Hasatio/esp32DevKitS/Rev0/Rev0.kicad_pcb

## KiCad design Rev0/Rev0.kicad_pcb (2024-02-27, an earlier design)

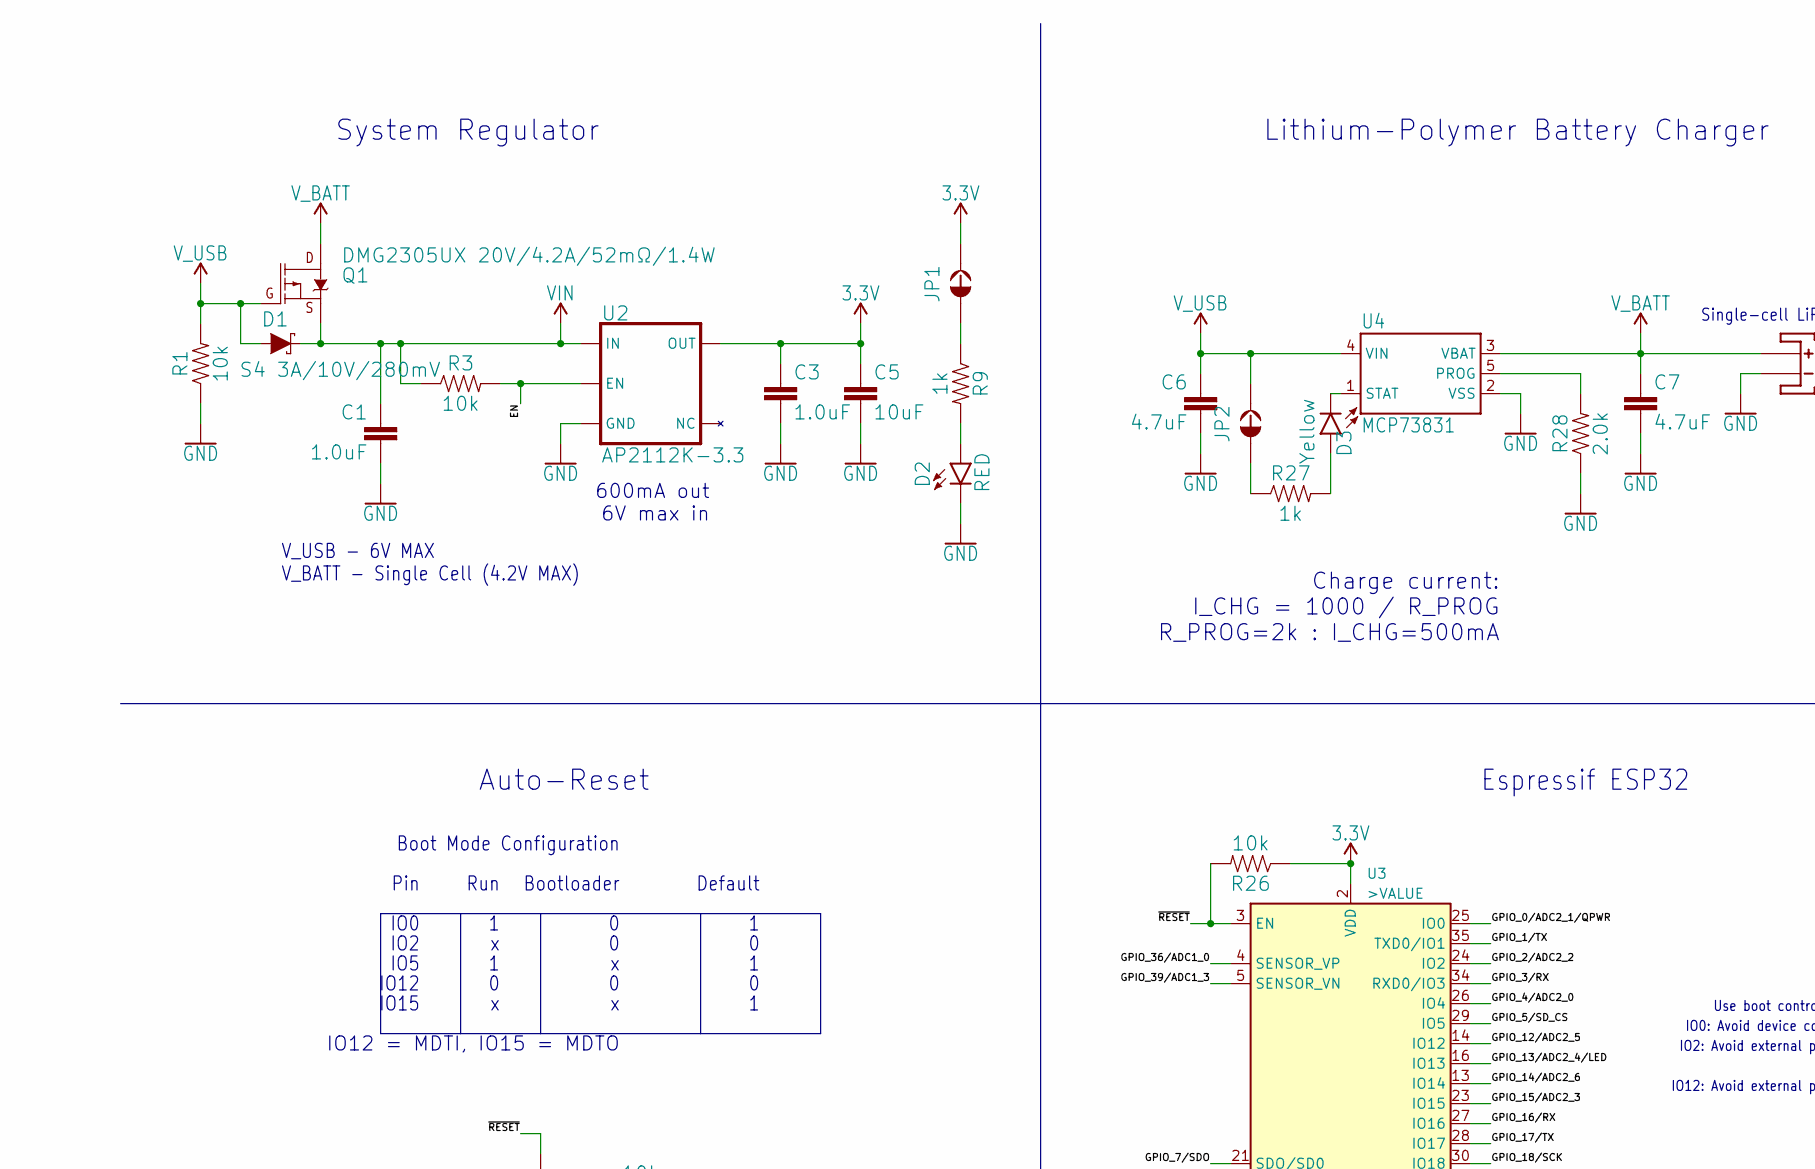
[picture p1: schematic Rev0.kicad_sch, ESP32-DEVKIT-S, part in row 1, column 1]

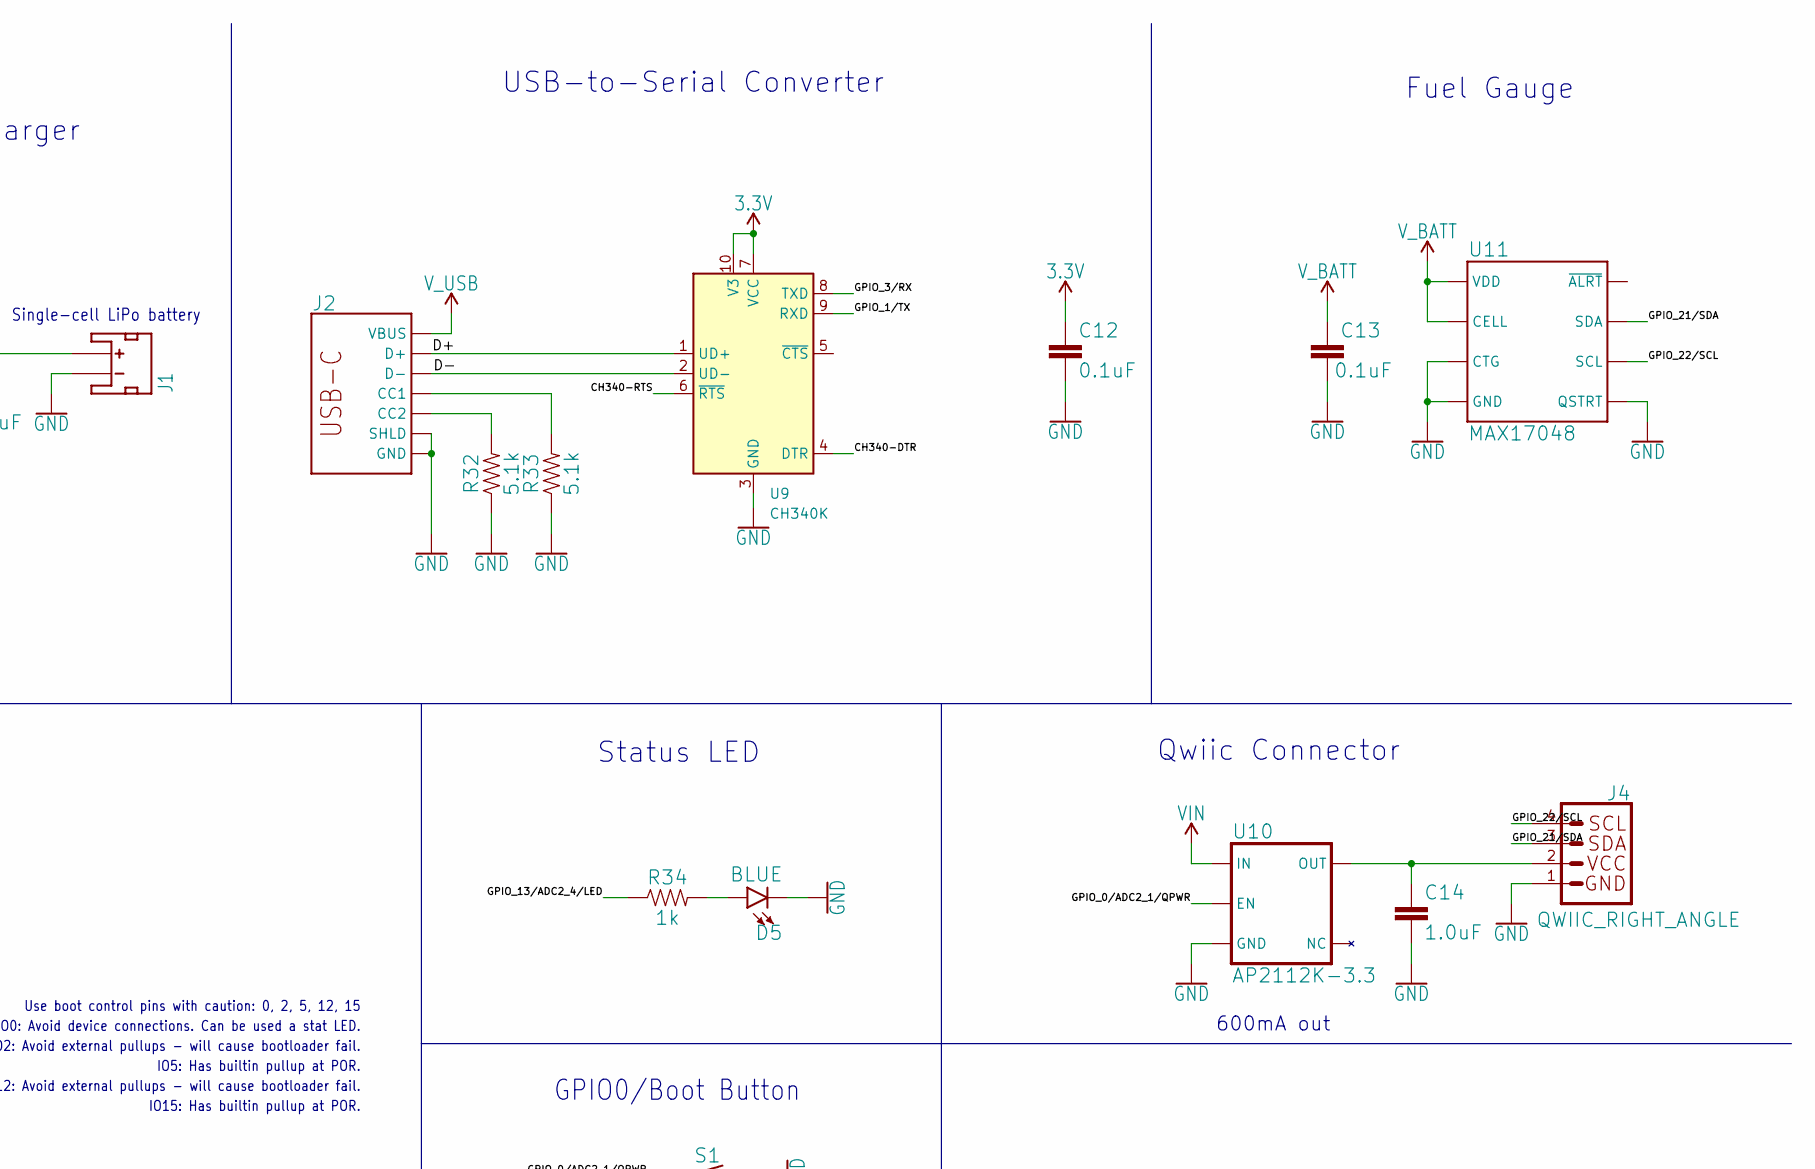
[picture p2: schematic Rev0.kicad_sch, ESP32-DEVKIT-S, part in row 1, column 2]

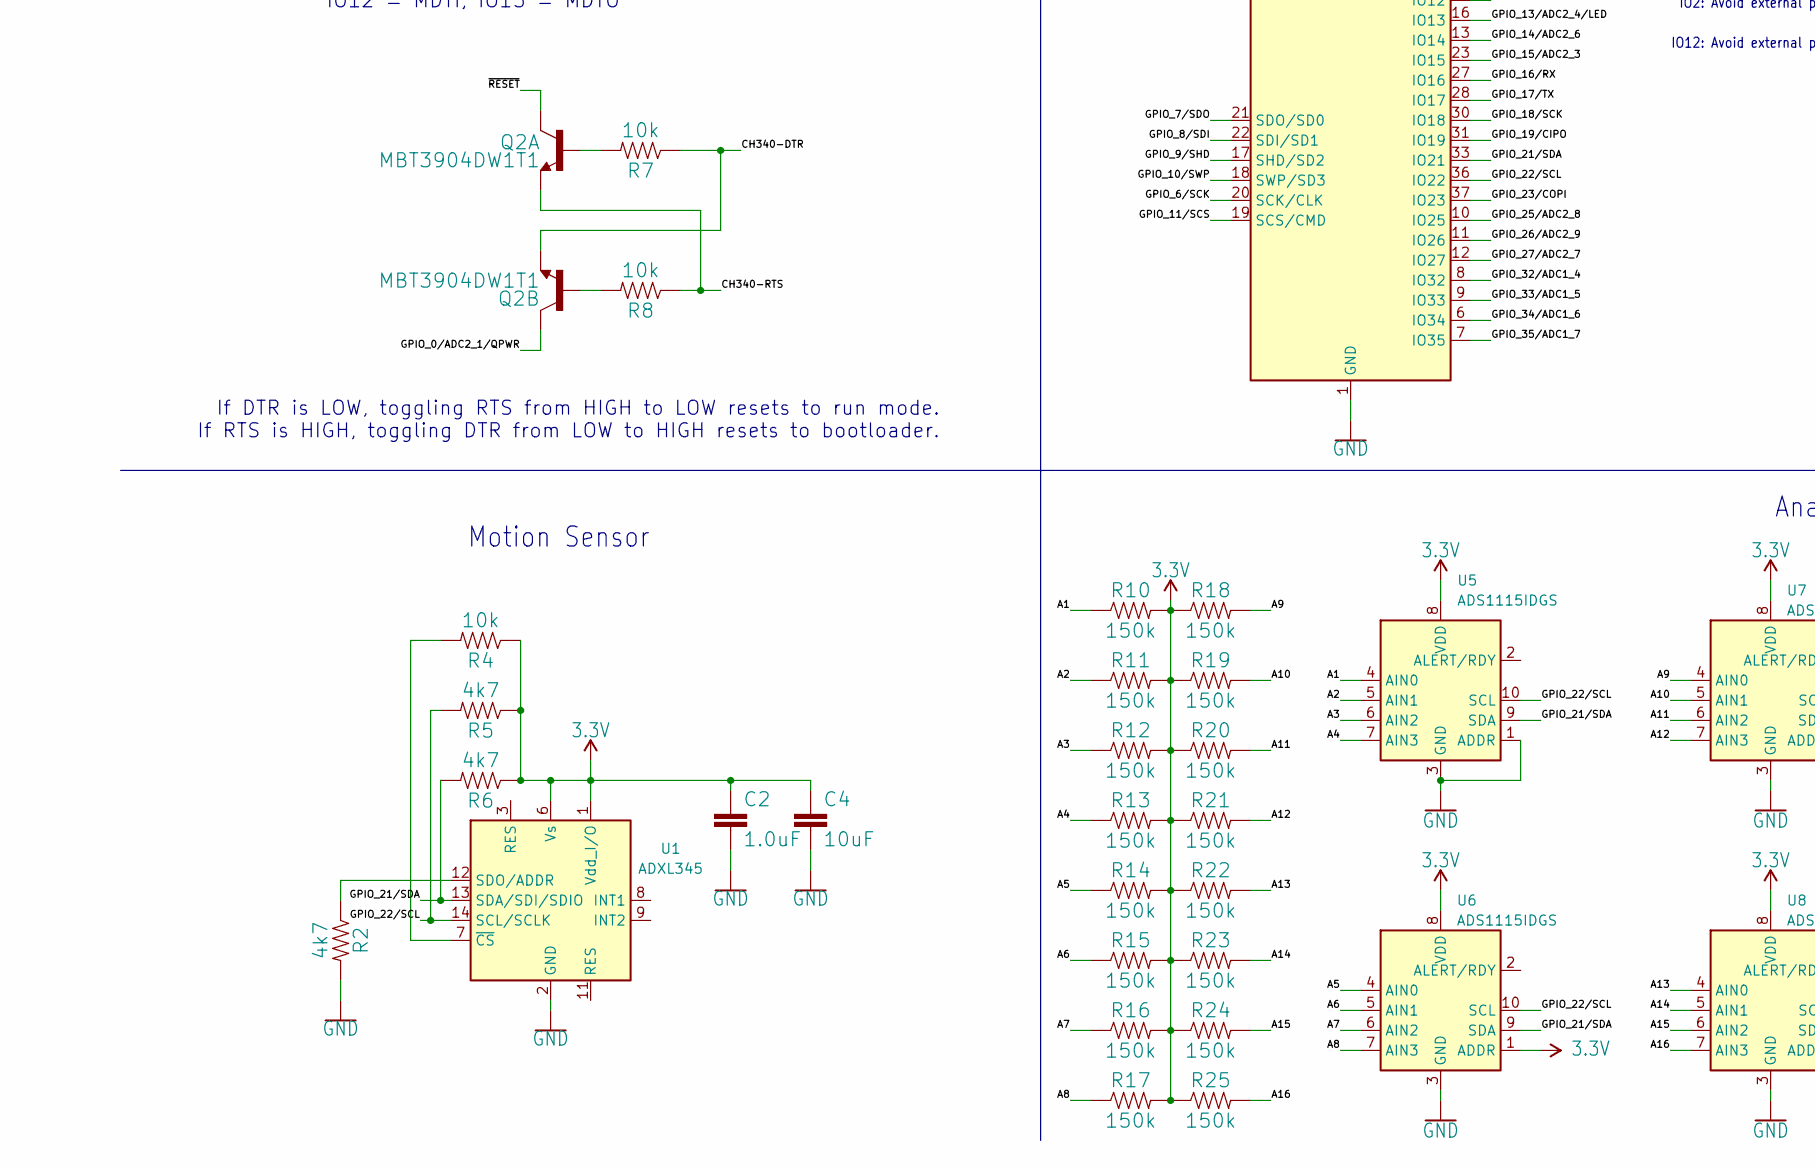
[picture p3: schematic Rev0.kicad_sch, ESP32-DEVKIT-S, part in row 2, column 1]

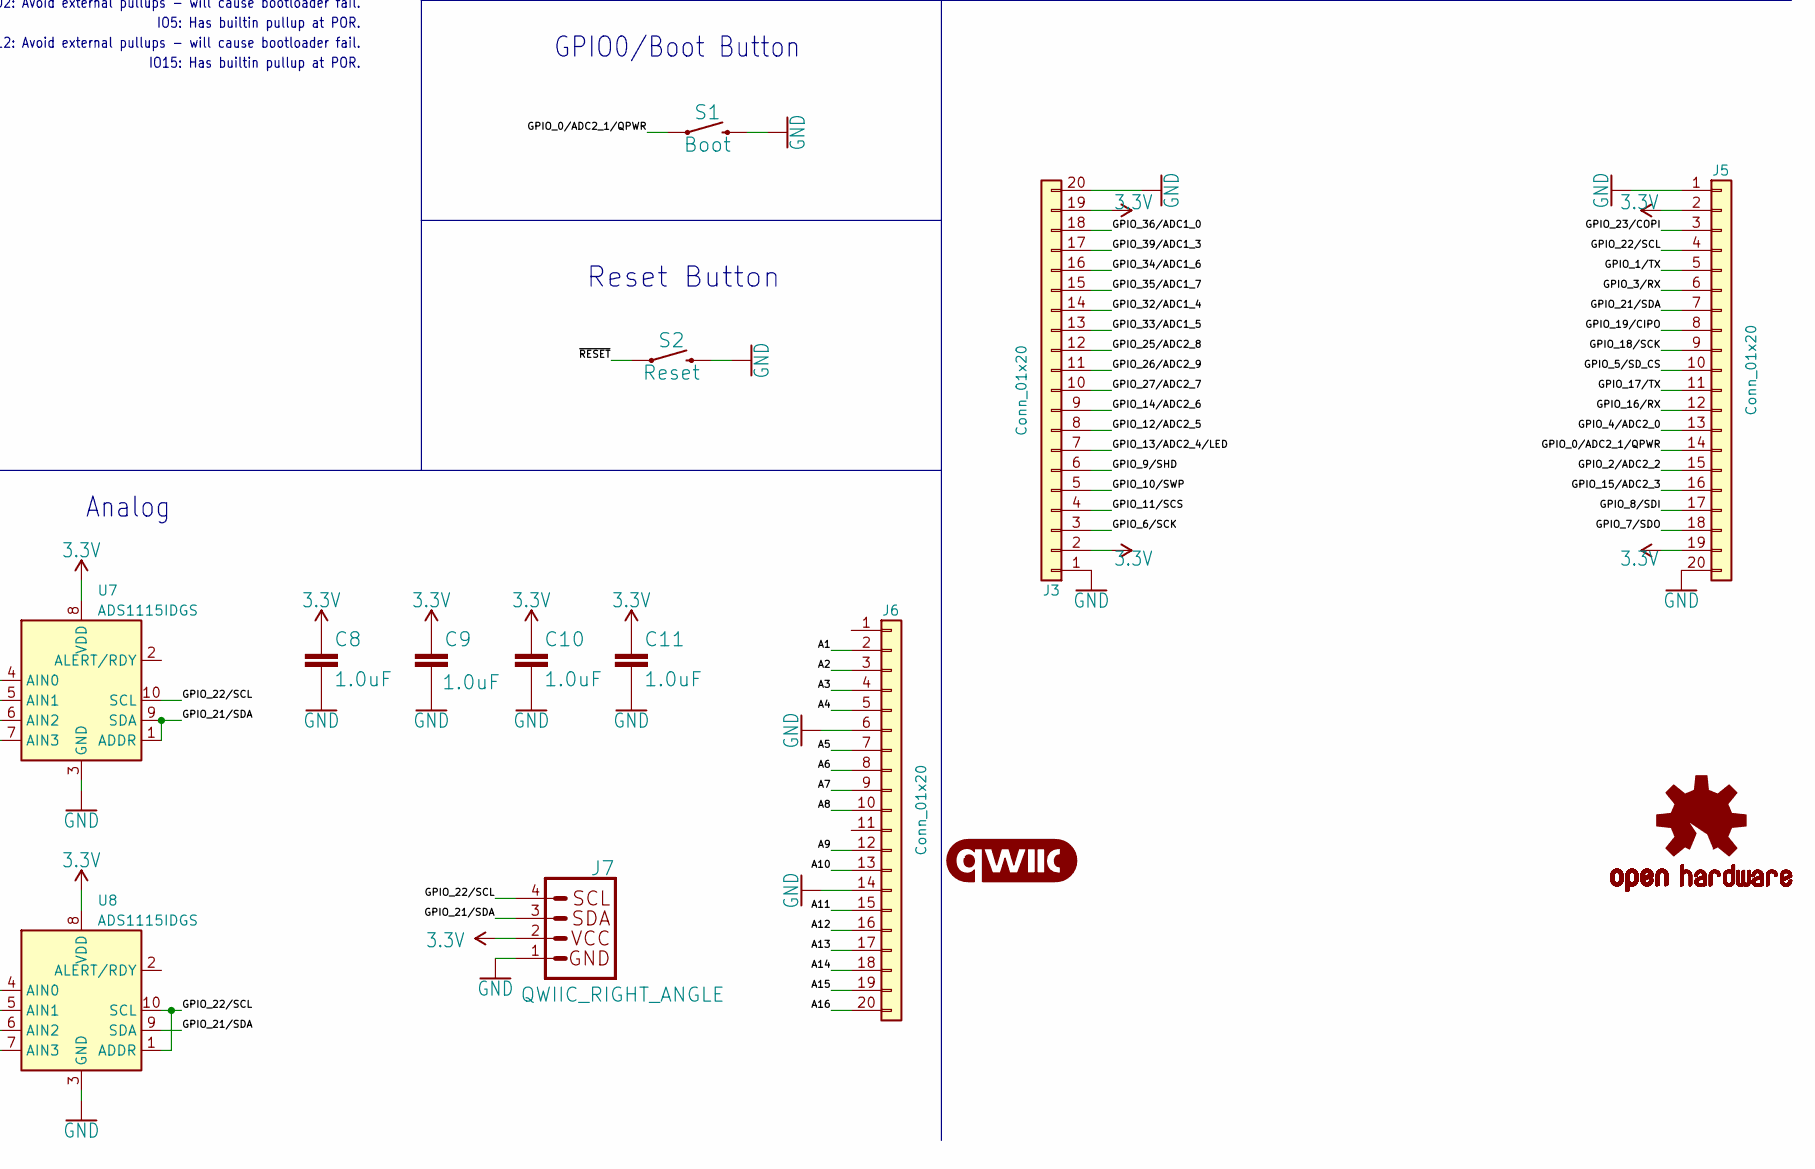
[picture p4: schematic Rev0.kicad_sch, ESP32-DEVKIT-S, part in row 2, column 2]

Parts:
C1, C2, C3, C8, C9, C10, C11, C14: 1.0uF; 0402-TIGHT
C4, C5: 10uF; 0402-TIGHT
C6, C7: 4.7uF; 0402-TIGHT
C12, C13: 0.1uF; 0402-TIGHT
D1: S4 3A/10V/280mV; SOD-323
D2: RED; LED-0603
D3: Yellow; LED-0603
D5: BLUE; LED-0603
J1: JST_2MM_MALE; JST-2-SMD
J2: USB_C_2-LAYER_PADS; USB-C-16P-2LAYER-PADS
J3, J5, J6: Conn_01x20; Molex_200528-0200_1x20-1MP_P1.00mm_Horizontal
J4, J7: QWIIC_RIGHT_ANGLE; JST04_1MM_RA
JP1, JP2: JUMPER-SMT_2_NC_TRACE_SILK; SMT-JUMPER_2_NC_TRACE_SILK
LOGO1: QWIIC_LOGO_4MM; QWIIC_4MM
LOGO2: OSHW-LOGOMINI; OSHW-LOGO-MINI
Q1: DMG2305UX 20V/4.2A/52mΩ/1.4W; SOT23-3
Q2: MBT3904DW1T1; SC70-6
R1, R3, R4, R7, R8, R26: 10k; 0402-TIGHT
R2, R5, R6: 4k7; 0402-TIGHT
R9, R27, R34: 1k; 0402-TIGHT
R10, R11, R12, R13, R14, R15, R16, R17, R18, R19, R20, R21, R22, R23, R24, R25: 150k; 0402-TIGHT
R28: 2.0k; 0402-TIGHT
R32, R33: 5.1k; 0402-TIGHT
S1: Boot; TACTILE_SWITCH_SMD_4.6X2.8MM
S2: Reset; TACTILE_SWITCH_SMD_4.6X2.8MM
U1: ADXL345; LGA-14_3x5mm_P0.8mm_LayoutBorder1x6y
U2, U10: SOT23-5
U3: >VALUE; ESP-WROOM-32-NARROW
U4: MCP73831; SOT23-5
U5, U6, U7, U8: ADS1115IDGS; TSSOP-10_3x3mm_P0.5mm
U9: CH340K; SSOP-10_3.9x4.9mm_P1.00mm
U11: MAX17048; DFN-8

Connections:
3.3V: C2.1, C3.1, C4.1, C5.1, C8.1, C9.1, C10.1, C11.1, C12.1, J3.2, J3.19, J5.2, J5.19, J7.2, JP1.2, R4.1, R5.1, R6.1, R10.2, R11.2, R12.2, R13.2, R14.2, R15.2, R16.2, R17.2, R18.1, R19.1, R20.1, R21.1, R22.1, R23.1, R24.1, R25.1, R26.1, U1.1 (Vdd_I/O), U1.6 (Vs), U2.5 (OUT), U3.2 (VDD), U5.8 (VDD), U6.1 (ADDR), U6.8 (VDD), U7.8 (VDD), U8.8 (VDD), U9.7 (VCC), U9.10 (V3); also elsewhere on the board
/A1: J6.2, R10.1, U5.4 (AIN0); also elsewhere on the board
/A2: J6.3, R11.1, U5.5 (AIN1); also elsewhere on the board
/A3: J6.4, R12.1, U5.6 (AIN2); also elsewhere on the board
/A4: J6.5, R13.1, U5.7 (AIN3); also elsewhere on the board
/A5: J6.7, R14.1, U6.4 (AIN0); also elsewhere on the board
/A6: J6.8, R15.1, U6.5 (AIN1); also elsewhere on the board
/A7: J6.9, R16.1, U6.6 (AIN2); also elsewhere on the board
/A8: J6.10, R17.1, U6.7 (AIN3); also elsewhere on the board
/A9: J6.12, R18.2, U7.4 (AIN0); also elsewhere on the board
/A10: J6.13, R19.2, U7.5 (AIN1); also elsewhere on the board
/A11: J6.15, R20.2, U7.6 (AIN2); also elsewhere on the board
/A12: J6.16, R21.2, U7.7 (AIN3); also elsewhere on the board
/A13: J6.17, R22.2, U8.4 (AIN0); also elsewhere on the board
/A14: J6.18, R23.2, U8.5 (AIN1); also elsewhere on the board
/A15: J6.19, R24.2, U8.6 (AIN2); also elsewhere on the board
/A16: J6.20, R25.2, U8.7 (AIN3); also elsewhere on the board
/CH340-DTR: Q2.1 (E), R7.1, U9.4 (DTR)
/CH340-RTS: Q2.4 (E), R8.1, U9.6 (~RTS)
/D+: J2.A6 (D+), J2.B6 (D+), U9.1 (UD+)
/D-: J2.A7 (D-), J2.B7 (D-), U9.2 (UD-)
/EN: R3.2, U2.3 (EN)
/GPIO_0/ADC2_1/QPWR: J5.14, Q2.6 (C), S1.1, S1.2 (1), U3.25 (IO0), U10.3 (EN); also elsewhere on the board
/GPIO_2/ADC2_2: J5.15, U3.24 (IO2)
/GPIO_4/ADC2_0: J5.13, U3.26 (IO4)
/GPIO_5/SD_CS: J5.10, U3.29 (IO5)
/GPIO_6/SCK: J3.3, U3.20 (SCK/CLK)
/GPIO_7/SDO: J5.18, U3.21 (SDO/SD0)
/GPIO_8/SDI: J5.17, U3.22 (SDI/SD1)
/GPIO_9/SHD: J3.6, U3.17 (SHD/SD2)
/GPIO_10/SWP: J3.5, U3.18 (SWP/SD3)
/GPIO_11/SCS: J3.4, U3.19 (SCS/CMD)
/GPIO_12/ADC2_5: J3.8, U3.14 (IO12)
/GPIO_13/ADC2_4/LED: J3.7, R34.1, U3.16 (IO13)
/GPIO_14/ADC2_6: J3.9, U3.13 (IO14)
/GPIO_15/ADC2_3: J5.16, U3.23 (IO15)
/GPIO_16/RX: J5.12, U3.27 (IO16)
/GPIO_17/TX: J5.11, U3.28 (IO17)
/GPIO_18/SCK: J5.9, U3.30 (IO18)
/GPIO_19/CIPO: J5.8, U3.31 (IO19)
/GPIO_21/SDA: J4.3, J5.7, J7.3, R6.2, U1.13 (SDA/SDI/SDIO), U3.33 (IO21), U5.9 (SDA), U6.9 (SDA), U7.1 (ADDR), U7.9 (SDA), U8.9 (SDA), U11.8 (SDA); also elsewhere on the board
/GPIO_22/SCL: J4.4, J5.4, J7.4, R5.2, U1.14 (SCL/SCLK), U3.36 (IO22), U5.10 (SCL), U6.10 (SCL), U7.10 (SCL), U8.1 (ADDR), U8.10 (SCL), U11.7 (SCL); also elsewhere on the board
/GPIO_23/COPI: J5.3, U3.37 (IO23)
/GPIO_25/ADC2_8: J3.12, U3.10 (IO25)
/GPIO_26/ADC2_9: J3.11, U3.11 (IO26)
/GPIO_27/ADC2_7: J3.10, U3.12 (IO27)
/GPIO_32/ADC1_4: J3.14, U3.8 (IO32)
/GPIO_33/ADC1_5: J3.13, U3.9 (IO33)
/GPIO_34/ADC1_6: J3.16, U3.6 (IO34)
/GPIO_35/ADC1_7: J3.15, U3.7 (IO35)
/GPIO_36/ADC1_0: J3.18, U3.4 (SENSOR_VP)
/GPIO_39/ADC1_3: J3.17, U3.5 (SENSOR_VN)
/~RESET: Q2.3 (C), R26.2, S2.1, S2.2 (1), U3.3 (EN); also elsewhere on the board
GND: C1.2, C2.2, C3.2, C4.2, C5.2, C6.2, C7.2, C8.2, C9.2, C10.2, C11.2, C12.2, C13.2, C14.2, D2.C, D5.C, J1.1 (-), J2.GND, J2.GND2 (GND), J2.SHLD1 (SHLD), J2.SHLD2 (SHLD), J2.SHLD3 (SHLD), J2.SHLD4 (SHLD), J3.1, J3.20, J4.1, J5.1, J5.20, J6.6, J6.14, J7.1, R1.1, R2.2, R28.1, R32.1, R33.1, S1.3 (2), S1.4 (2), S2.3 (2), S2.4 (2), U1.2 (GND), U1.4 (GND), U1.5 (GND), U2.2 (GND), U3.1 (GND), U3.15 (GND), U3.38 (GND), U3.39 (GND), U4.2 (VSS), U5.1 (ADDR), U5.3 (GND), U6.3 (GND), U7.3 (GND), U8.3 (GND), U9.3 (GND), U10.2 (GND), U11.1 (CTG), U11.4 (GND), U11.6 (QSTRT), U11.9 (GND); also elsewhere on the board
unnamed: D2.A, R9.2
unnamed: D3.A, R27.2
unnamed: D5.A, R34.2
unnamed: J2.A5 (CC1), R33.2
unnamed: J2.B5 (CC2), R32.2
unnamed: JP1.1, R9.1
unnamed: JP2.1, R27.1
unnamed: Q2.5 (B), R7.2
unnamed: Q2.2 (B), R8.2
unnamed: R2.1, U1.12 (SDO/ADDR)
unnamed: R4.2, U1.7 (~CS)
unnamed: R28.2, U4.5 (PROG)
unnamed: D3.C, U4.1 (STAT)
unnamed: C14.1, J4.2, U10.5 (OUT)
VIN: C1.1, D1.C, Q1.2 (S), R3.1, U2.1 (IN), U10.1 (IN)
V_BATT: C7.1, C13.1, J1.2 (+), Q1.3 (D), U4.3 (VBAT), U11.2 (CELL), U11.3 (VDD)
V_USB: C6.1, D1.A, J2.VBUS1 (VBUS), J2.VBUS2 (VBUS), JP2.2, Q1.1 (G), R1.2, U4.4 (VIN)

Notes on the sheet:
Fuel Gauge
Auto-Reset
IO15
Boot Mode Configuration
Reset Button
Default
Pin
IO5: Has builtin pullup at POR.
IO5
Run
Qwiic Connector
IO0
V_USB - 6V MAX V_BATT - Single Cell (4.2V MAX)
Lithium-Polymer Battery Charger
IO2
IO12: Avoid external pullups - will cause bootloader fail.
Espressif ESP32
IO12
USB-to-Serial Converter
IO15: Has builtin pullup at POR.
Motion Sensor
Analog
Status LED
Bootloader
Use boot control pins with caution: 0, 2, 5, 12, 15
GPIO0/Boot Button
Charge current: I_CHG = 1000 / R_PROG R_PROG=2k : I_CHG=500mA
Single-cell LiPo battery
IO0: Avoid device connections. Can be used a stat LED.
600mA out
600mA out 6V max in
If DTR is LOW, toggling RTS from HIGH to LOW resets to run mode. If RTS is HIGH, toggling DTR from LOW to HIGH resets to bootloader.
IO2: Avoid external pullups - will cause bootloader fail.
IO12 = MDTI, IO15 = MDTO
System Regulator

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
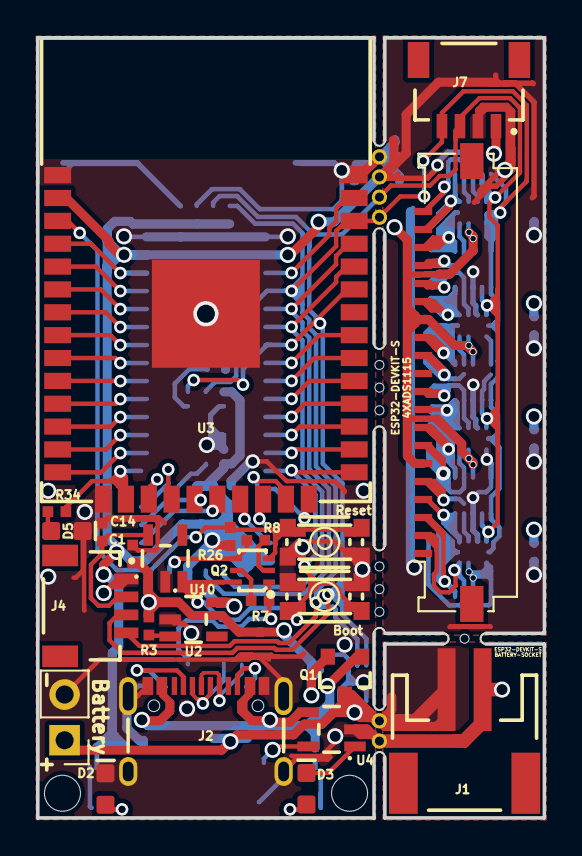
[picture p5: board Rev0.kicad_pcb from above]

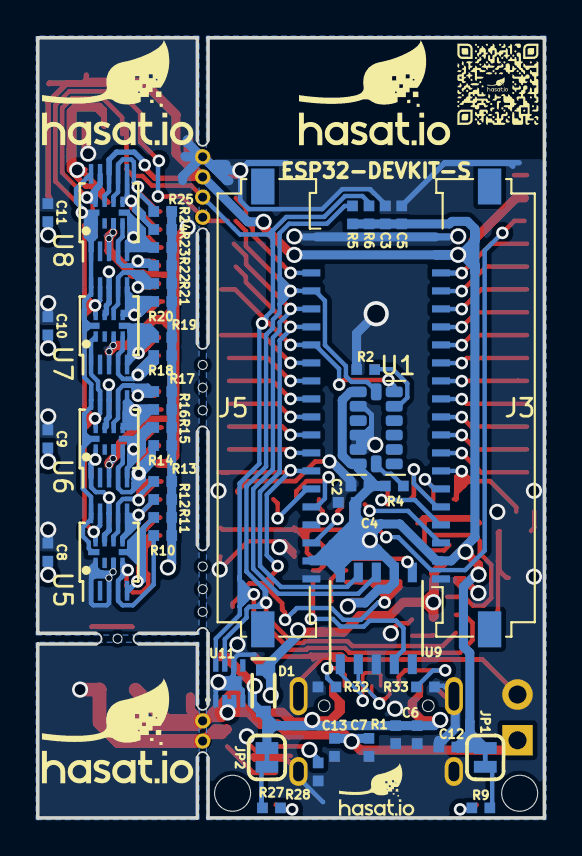
[picture p6: board Rev0.kicad_pcb from below]

Board: 2 copper layers, 28.1 x 43.3 mm, 85 parts (54 on the bottom side), 73 nets.

Other parts of the board:
>NAME: >VALUE; TACTILE_SWITCH_SMD_2.8X1.9MM
>NAME#2: >VALUE; TACTILE_SWITCH_SMD_2.8X1.9MM
>NAME#3, >NAME#4, >NAME#5, >NAME#6: >VALUE; QFN-10-RSE
FRAME1: FRAME-LEDGER; CREATIVE_COMMONS
mouse-bite-1mm-slot, mouse-bite-1mm-slot#2: VAL**; mouse-bite-1mm x4
mouse-bite-1mm-slot#3: VAL**; mouse-bite-1mm x2
mouse-bite-1mm-slot#4: VAL**; mouse-bite-1mm 4
mouse-bite-emm-slot: VAL**; mouse-bite-1mm 2

Their connections:
3.3V: >NAME#3.1, >NAME#3.8, >NAME#4.8, >NAME#5.8, >NAME#6.8; also elsewhere on the board
/A1: >NAME#5.4; also elsewhere on the board
/A2: >NAME#5.5; also elsewhere on the board
/A3: >NAME#5.6; also elsewhere on the board
/A4: >NAME#5.7; also elsewhere on the board
/A5: >NAME#3.4; also elsewhere on the board
/A6: >NAME#3.5; also elsewhere on the board
/A7: >NAME#3.6; also elsewhere on the board
/A8: >NAME#3.7; also elsewhere on the board
/A9: >NAME#6.4; also elsewhere on the board
/A10: >NAME#6.5; also elsewhere on the board
/A11: >NAME#6.6; also elsewhere on the board
/A12: >NAME#6.7; also elsewhere on the board
/A13: >NAME#4.4; also elsewhere on the board
/A14: >NAME#4.5; also elsewhere on the board
/A15: >NAME#4.6; also elsewhere on the board
/A16: >NAME#4.7; also elsewhere on the board
/GPIO_0/ADC2_1/QPWR: >NAME.1, >NAME.3; also elsewhere on the board
/GPIO_21/SDA: >NAME#3.9, >NAME#4.9, >NAME#5.9, >NAME#6.1, >NAME#6.9; also elsewhere on the board
/GPIO_22/SCL: >NAME#3.10, >NAME#4.1, >NAME#4.10, >NAME#5.10, >NAME#6.10; also elsewhere on the board
/~RESET: >NAME#2.2, >NAME#2.4; also elsewhere on the board
GND: >NAME.2, >NAME.4, >NAME#2.1, >NAME#2.3, >NAME#3.3, >NAME#4.3, >NAME#5.1, >NAME#5.3, >NAME#6.3; also elsewhere on the board
