Hasatio/esp32DevKitS/Rev1/panelization/panelization.kicad_pcb

## KiCad design Rev1/panelization/panelization.kicad_pcb (2023-07-02, an earlier design)

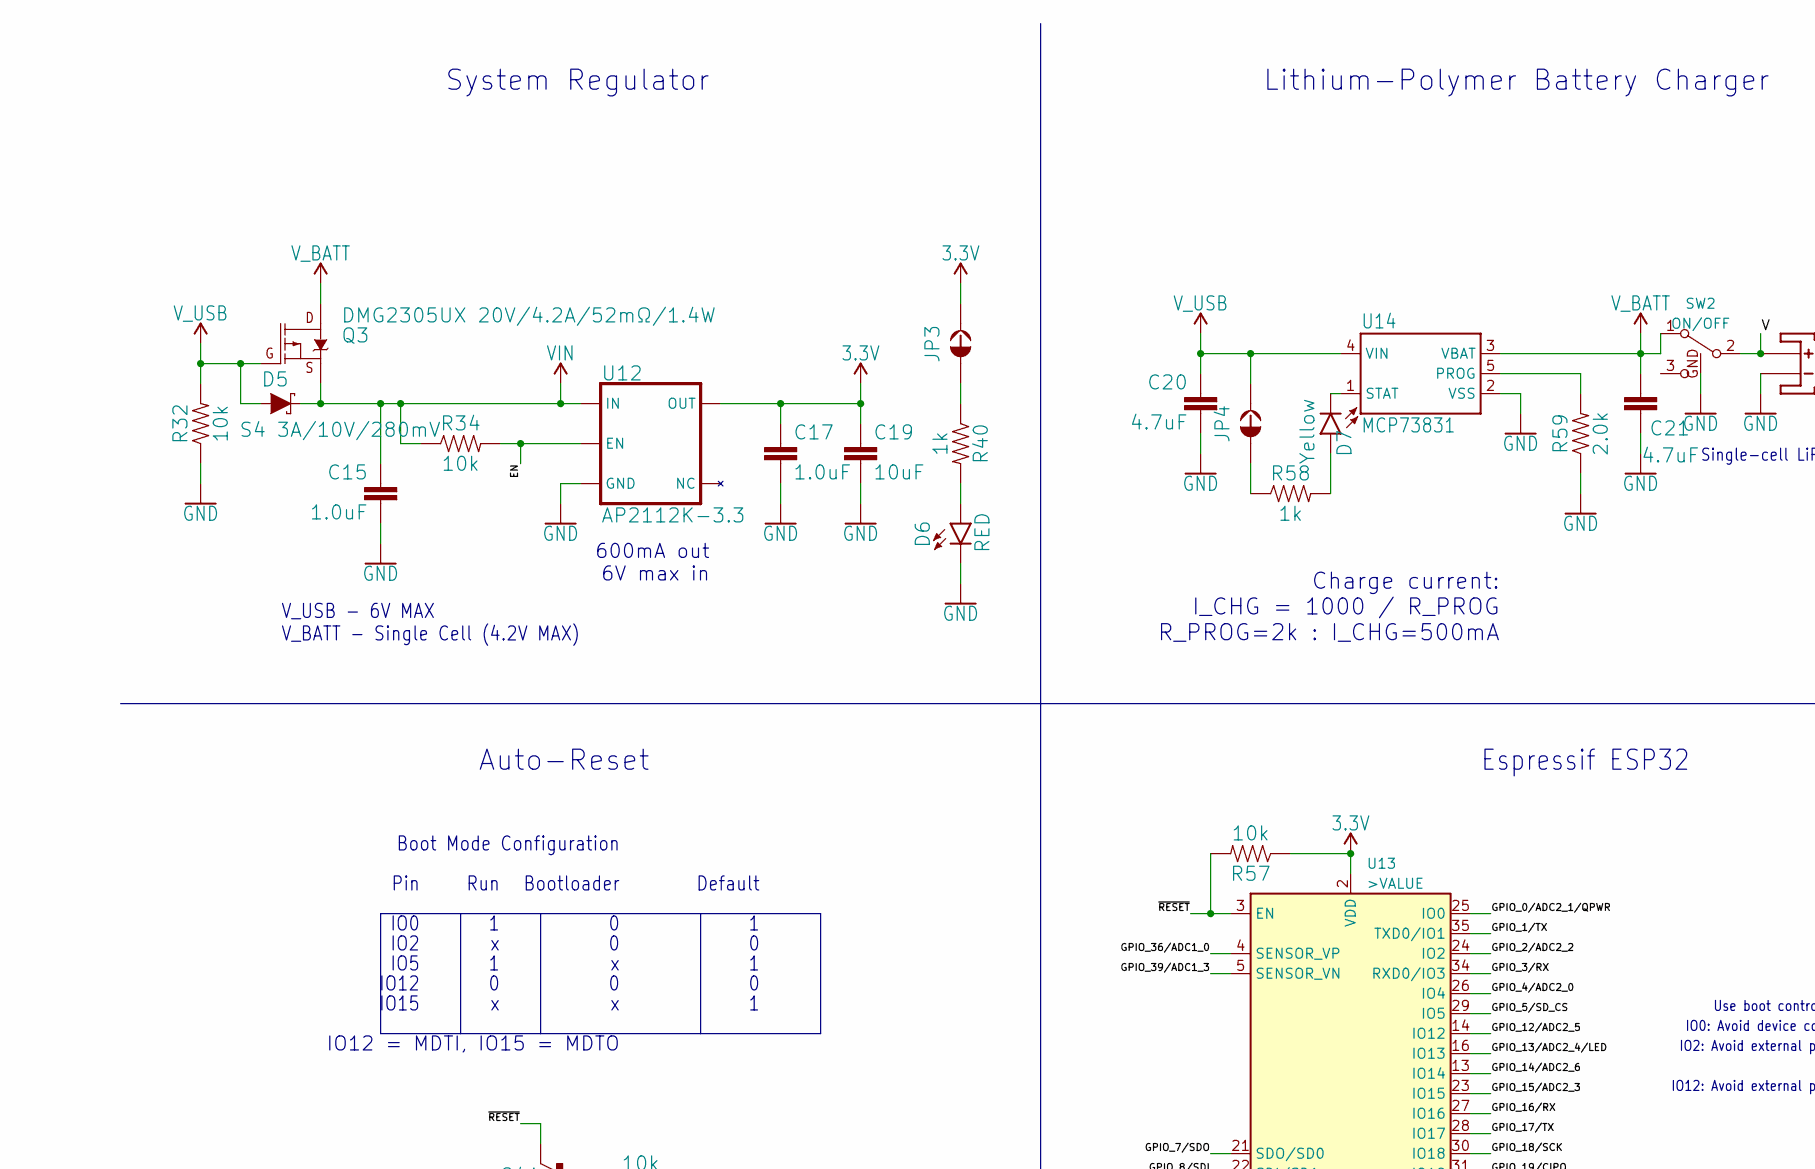
[picture p7: schematic L.kicad_sch, posture, part in row 1, column 1]

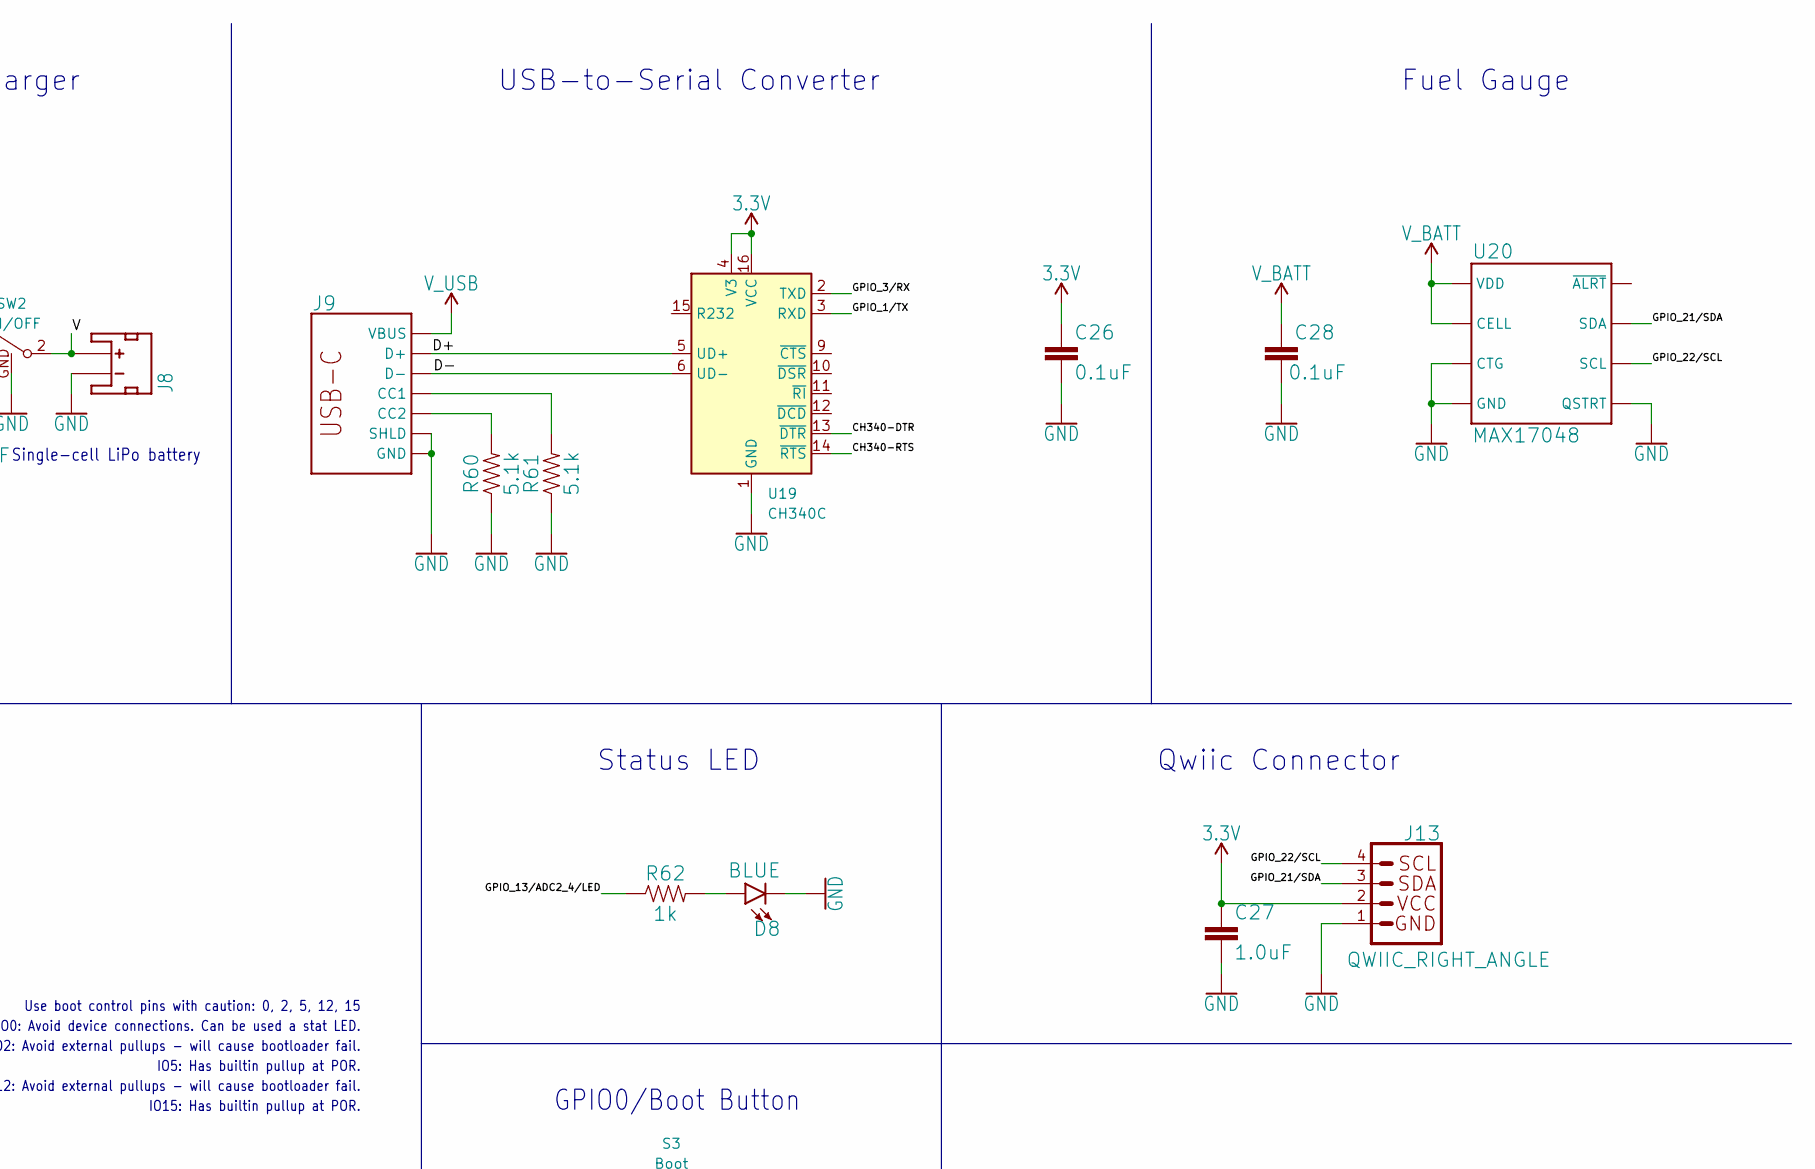
[picture p8: schematic L.kicad_sch, posture, part in row 1, column 2]

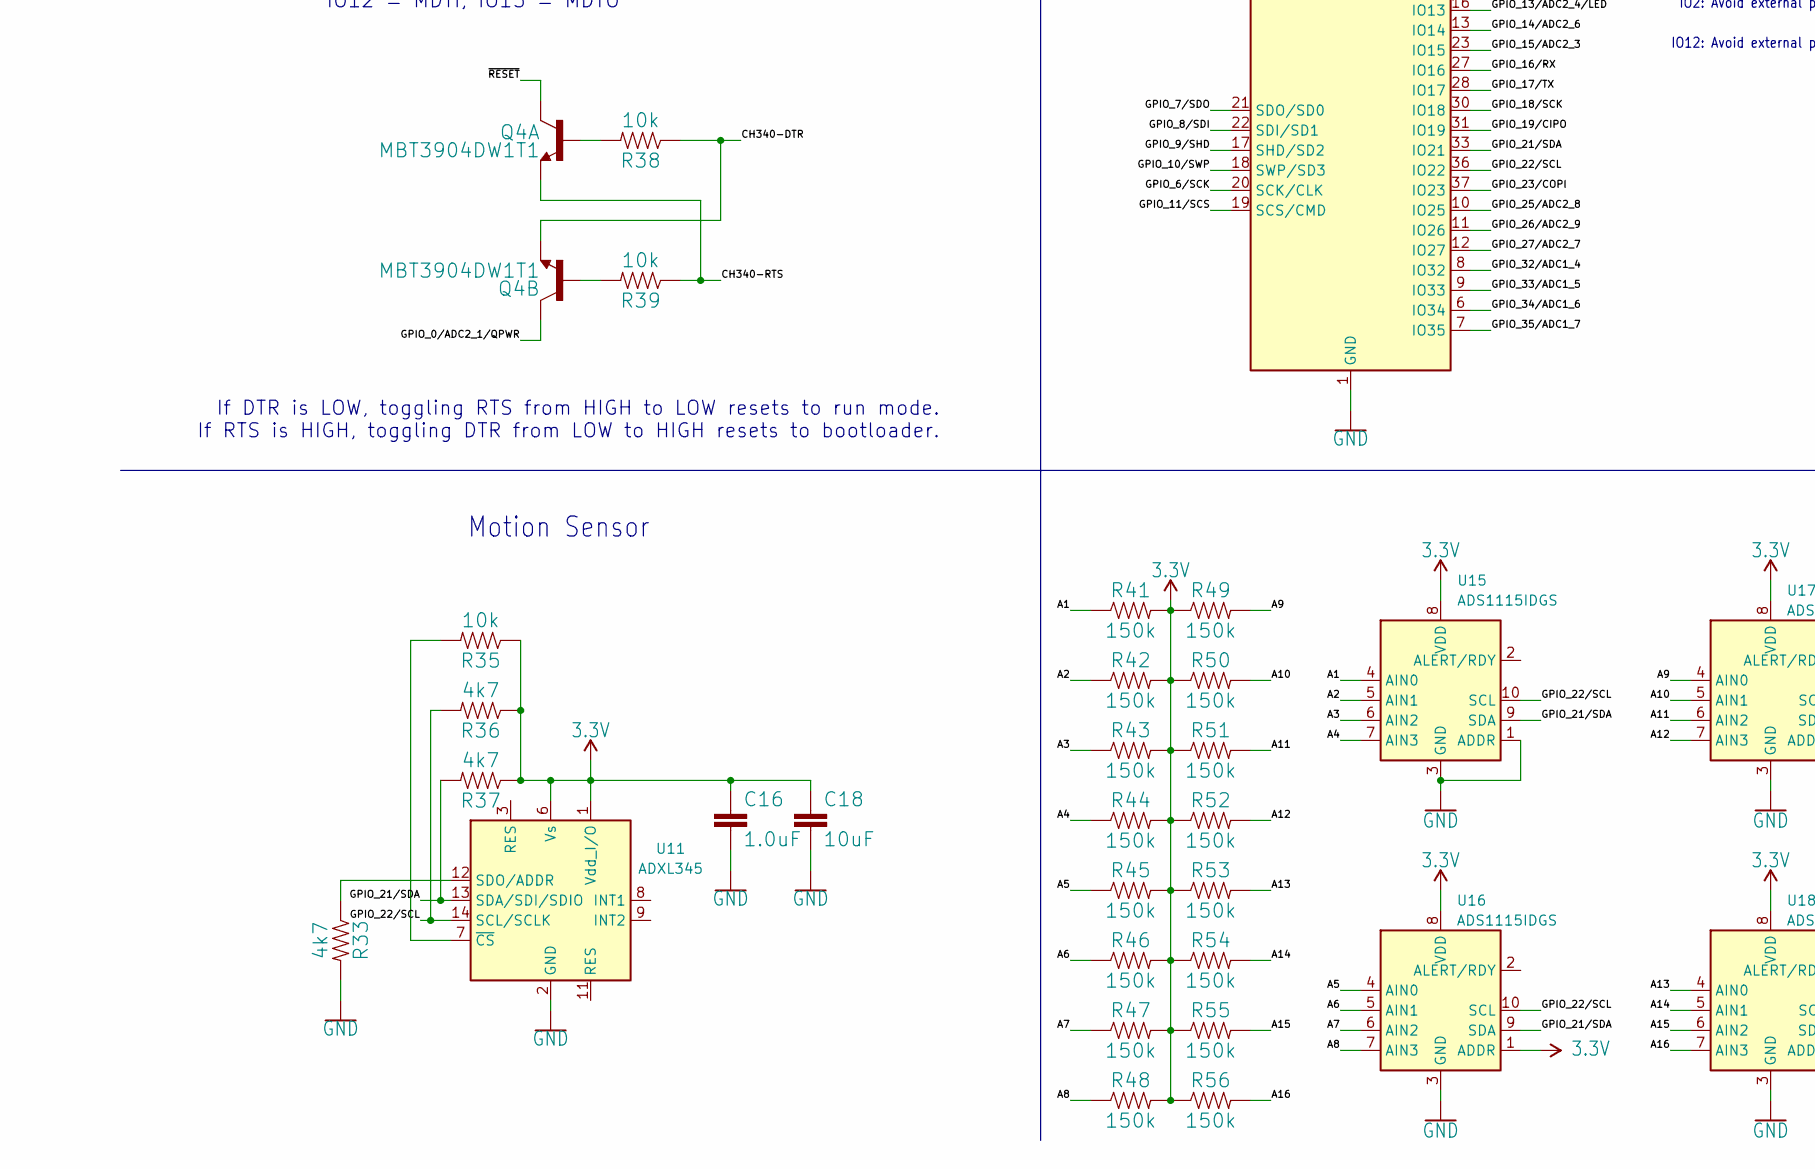
[picture p9: schematic L.kicad_sch, posture, part in row 2, column 1]

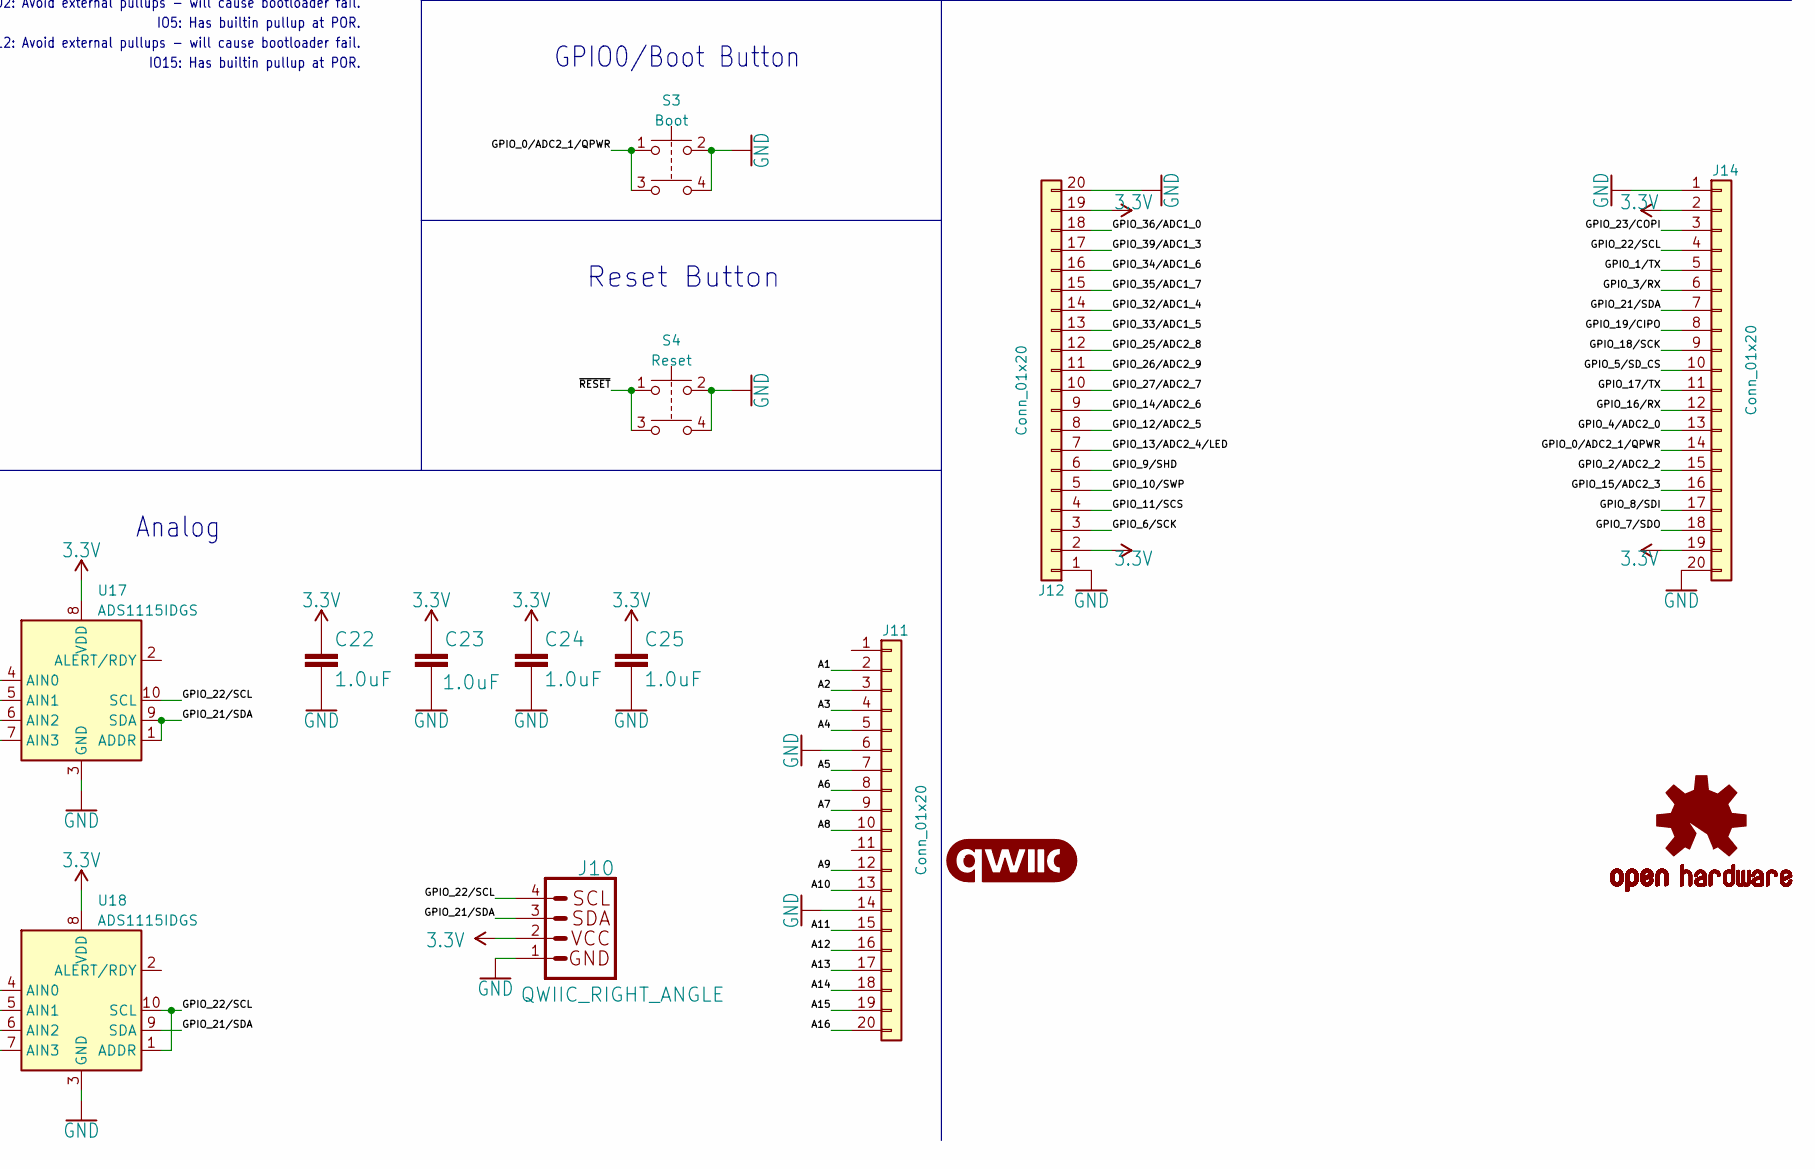
[picture p10: schematic L.kicad_sch, posture, part in row 2, column 2]

Parts:
C15, C16, C17, C22, C23, C24, C25, C27: 1.0uF; 0402-TIGHT
C18, C19: 10uF; 0402-TIGHT
C20, C21: 4.7uF; 0402-TIGHT
C26, C28: 0.1uF; 0402-TIGHT
D5: S4 3A/10V/280mV; SOD-323
D6: RED; LED-0603
D7: Yellow; LED-0603
D8: BLUE; LED-0603
J8: JST_2MM_MALE; JST-2-SMD
J9: USB_C_2-LAYER_PADS; USB-C-16P-2LAYER-PADS
J10, J13: QWIIC_RIGHT_ANGLE; JST04_1MM_RA
J11, J12, J14: Conn_01x20; Molex_200528-0200_1x20-1MP_P1.00mm_Horizontal
JP3, JP4: JUMPER-SMT_2_NC_TRACE_SILK; SMT-JUMPER_2_NC_TRACE_SILK
LOGO3: QWIIC_LOGO_4MM; QWIIC_4MM
LOGO4: OSHW-LOGOMINI; OSHW-LOGO-MINI
Q3: DMG2305UX 20V/4.2A/52mΩ/1.4W; SOT23-3
Q4: MBT3904DW1T1; SC70-6
R32, R34, R35, R38, R39, R57: 10k; 0402-TIGHT
R33, R36, R37: 4k7; 0402-TIGHT
R40, R58, R62: 1k; 0402-TIGHT
R41, R42, R43, R44, R45, R46, R47, R48, R49, R50, R51, R52, R53, R54, R55, R56: 150k; 0402-TIGHT
R59: 2.0k; 0402-TIGHT
R60, R61: 5.1k; 0402-TIGHT
S3: Boot; TACTILE_SWITCH_SMD_2.8X1.9MM
S4: Reset; TACTILE_SWITCH_SMD_2.8X1.9MM
SW2: ON/OFF; SW_SPDT_k3-1295
U11: ADXL345; LGA-14_3x5mm_P0.8mm_LayoutBorder1x6y
U12: SOT23-5
U13: >VALUE; ESP-WROOM-32-NARROW
U14: MCP73831; SOT23-5
U15, U16, U17, U18: ADS1115IDGS; TSSOP-10_3x3mm_P0.5mm
U19: CH340C; SOIC-16_3.9x9.9mm_P1.27mm
U20: MAX17048; DFN-8

Connections:
Board_1-3.3V: C16.1, C17.1, C18.1, C19.1, C22.1, C23.1, C24.1, C25.1, C26.1, C27.1, J10.2, J12.2, J12.19, J13.2, J14.2, J14.19, JP3.2, R35.1, R36.1, R37.1, R41.2, R42.2, R43.2, R44.2, R45.2, R46.2, R47.2, R48.2, R49.1, R50.1, R51.1, R52.1, R53.1, R54.1, R55.1, R56.1, R57.1, U11.1 (Vdd_I/O), U11.6 (Vs), U12.5 (OUT), U13.2 (VDD), U15.8 (VDD), U16.1 (ADDR), U16.8 (VDD), U17.8 (VDD), U18.8 (VDD), U19.4 (V3), U19.16 (VCC); also elsewhere on the board
Board_1-/A1: J11.2, R41.1, U15.4 (AIN0); also elsewhere on the board
Board_1-/A2: J11.3, R42.1, U15.5 (AIN1); also elsewhere on the board
Board_1-/A3: J11.4, R43.1, U15.6 (AIN2); also elsewhere on the board
Board_1-/A4: J11.5, R44.1, U15.7 (AIN3); also elsewhere on the board
Board_1-/A5: J11.7, R45.1, U16.4 (AIN0); also elsewhere on the board
Board_1-/A6: J11.8, R46.1, U16.5 (AIN1); also elsewhere on the board
Board_1-/A7: J11.9, R47.1, U16.6 (AIN2); also elsewhere on the board
Board_1-/A8: J11.10, R48.1, U16.7 (AIN3); also elsewhere on the board
Board_1-/A9: J11.12, R49.2, U17.4 (AIN0); also elsewhere on the board
Board_1-/A10: J11.13, R50.2, U17.5 (AIN1); also elsewhere on the board
Board_1-/A11: J11.15, R51.2, U17.6 (AIN2); also elsewhere on the board
Board_1-/A12: J11.16, R52.2, U17.7 (AIN3); also elsewhere on the board
Board_1-/A13: J11.17, R53.2, U18.4 (AIN0); also elsewhere on the board
Board_1-/A14: J11.18, R54.2, U18.5 (AIN1); also elsewhere on the board
Board_1-/A15: J11.19, R55.2, U18.6 (AIN2); also elsewhere on the board
Board_1-/A16: J11.20, R56.2, U18.7 (AIN3); also elsewhere on the board
Board_1-/CH340-DTR: Q4.1 (E), R38.1, U19.13 (~DTR)
Board_1-/CH340-RTS: Q4.4 (E), R39.1, U19.14 (~RTS)
Board_1-/D+: J9.A6 (D+), J9.B6 (D+), U19.5 (UD+)
Board_1-/D-: J9.A7 (D-), J9.B7 (D-), U19.6 (UD-)
Board_1-/EN: R34.2, U12.3 (EN)
Board_1-/GPIO_0/ADC2_1/QPWR: J14.14, Q4.6 (C), S3.1, S3.3, U13.25 (IO0)
Board_1-/GPIO_2/ADC2_2: J14.15, U13.24 (IO2)
Board_1-/GPIO_4/ADC2_0: J14.13, U13.26 (IO4)
Board_1-/GPIO_5/SD_CS: J14.10, U13.29 (IO5)
Board_1-/GPIO_6/SCK: J12.3, U13.20 (SCK/CLK)
Board_1-/GPIO_7/SDO: J14.18, U13.21 (SDO/SD0)
Board_1-/GPIO_8/SDI: J14.17, U13.22 (SDI/SD1)
Board_1-/GPIO_9/SHD: J12.6, U13.17 (SHD/SD2)
Board_1-/GPIO_10/SWP: J12.5, U13.18 (SWP/SD3)
Board_1-/GPIO_11/SCS: J12.4, U13.19 (SCS/CMD)
Board_1-/GPIO_12/ADC2_5: J12.8, U13.14 (IO12)
Board_1-/GPIO_13/ADC2_4/LED: J12.7, R62.1, U13.16 (IO13)
Board_1-/GPIO_14/ADC2_6: J12.9, U13.13 (IO14)
Board_1-/GPIO_15/ADC2_3: J14.16, U13.23 (IO15)
Board_1-/GPIO_16/RX: J14.12, U13.27 (IO16)
Board_1-/GPIO_17/TX: J14.11, U13.28 (IO17)
Board_1-/GPIO_18/SCK: J14.9, U13.30 (IO18)
Board_1-/GPIO_19/CIPO: J14.8, U13.31 (IO19)
Board_1-/GPIO_21/SDA: J10.3, J13.3, J14.7, R37.2, U11.13 (SDA/SDI/SDIO), U13.33 (IO21), U15.9 (SDA), U16.9 (SDA), U17.1 (ADDR), U17.9 (SDA), U18.9 (SDA), U20.8 (SDA); also elsewhere on the board
Board_1-/GPIO_22/SCL: J10.4, J13.4, J14.4, R36.2, U11.14 (SCL/SCLK), U13.36 (IO22), U15.10 (SCL), U16.10 (SCL), U17.10 (SCL), U18.1 (ADDR), U18.10 (SCL), U20.7 (SCL); also elsewhere on the board
Board_1-/GPIO_23/COPI: J14.3, U13.37 (IO23)
Board_1-/GPIO_25/ADC2_8: J12.12, U13.10 (IO25)
Board_1-/GPIO_26/ADC2_9: J12.11, U13.11 (IO26)
Board_1-/GPIO_27/ADC2_7: J12.10, U13.12 (IO27)
Board_1-/GPIO_32/ADC1_4: J12.14, U13.8 (IO32)
Board_1-/GPIO_33/ADC1_5: J12.13, U13.9 (IO33)
Board_1-/GPIO_34/ADC1_6: J12.16, U13.6 (IO34)
Board_1-/GPIO_35/ADC1_7: J12.15, U13.7 (IO35)
Board_1-/GPIO_36/ADC1_0: J12.18, U13.4 (SENSOR_VP)
Board_1-/GPIO_39/ADC1_3: J12.17, U13.5 (SENSOR_VN)
Board_1-/V: J8.2 (+), SW2.2 (B)
Board_1-/~RESET: Q4.3 (C), R57.2, S4.1, S4.3, U13.3 (EN)
Board_1-GND: C15.2, C16.2, C17.2, C18.2, C19.2, C20.2, C21.2, C22.2, C23.2, C24.2, C25.2, C26.2, C27.2, C28.2, D6.C, D8.C, J8.1 (-), J9.GND, J9.GND2 (GND), J9.SHLD1 (SHLD), J9.SHLD2 (SHLD), J9.SHLD3 (SHLD), J9.SHLD4 (SHLD), J10.1, J11.6, J11.14, J12.1, J12.20, J13.1, J14.1, J14.20, R32.1, R33.2, R59.1, R60.1, R61.1, S3.2, S3.4, S4.2, S4.4, SW2.GND, U11.2 (GND), U11.4 (GND), U11.5 (GND), U12.2 (GND), U13.1 (GND), U13.15 (GND), U13.38 (GND), U13.39 (GND), U14.2 (VSS), U15.1 (ADDR), U15.3 (GND), U16.3 (GND), U17.3 (GND), U18.3 (GND), U19.1 (GND), U20.1 (CTG), U20.4 (GND), U20.6 (QSTRT), U20.9 (GND); also elsewhere on the board
Board_1-Net-(D6-PadA): D6.A, R40.2
Board_1-Net-(D7-PadA): D7.A, R58.2
Board_1-Net-(D8-PadA): D8.A, R62.2
Board_1-Net-(J9-CC1): J9.A5 (CC1), R61.2
Board_1-Net-(J9-CC2): J9.B5 (CC2), R60.2
Board_1-Net-(JP3-Pad1): JP3.1, R40.1
Board_1-Net-(JP4-Pad1): JP4.1, R58.1
Board_1-Net-(Q4A-B): Q4.5 (B), R38.2
Board_1-Net-(Q4B-B): Q4.2 (B), R39.2
Board_1-Net-(U11-SDO/ADDR): R33.1, U11.12 (SDO/ADDR)
Board_1-Net-(U11-~CS): R35.2, U11.7 (~CS)
Board_1-Net-(U14-PROG): R59.2, U14.5 (PROG)
Board_1-Net-(U14-STAT): D7.C, U14.1 (STAT)
Board_1-VIN: C15.1, D5.C, Q3.2 (S), R34.1, U12.1 (IN)
Board_1-V_BATT: C21.1, C28.1, Q3.3 (D), SW2.1 (A), U14.3 (VBAT), U20.2 (CELL), U20.3 (VDD)
Board_1-V_USB: C20.1, D5.A, J9.VBUS1 (VBUS), J9.VBUS2 (VBUS), JP4.2, Q3.1 (G), R32.2, U14.4 (VIN)
Board_1-unconnected-(J8-PAD1-PadNC1): J8.NC1 (PAD1)
Board_1-unconnected-(J8-PAD2-PadNC2): J8.NC2 (PAD2)
Board_1-unconnected-(J11-Pin_1-Pad1): J11.1
Board_1-unconnected-(J11-Pin_11-Pad11): J11.11
Board_1-unconnected-(SW2-C-Pad3): SW2.3 (C)
Board_1-unconnected-(U11-INT1-Pad8): U11.8 (INT1)
Board_1-unconnected-(U11-INT2-Pad9): U11.9 (INT2)
Board_1-unconnected-(U11-NC-Pad10): U11.10 (NC)
Board_1-unconnected-(U11-RES-Pad3): U11.3 (RES)
Board_1-unconnected-(U11-RES-Pad11): U11.11 (RES)
Board_1-unconnected-(U12-NC-Pad4): U12.4 (NC)
Board_1-unconnected-(U13-NC-Pad32): U13.32 (NC)
Board_1-unconnected-(U15-ALERT/RDY-Pad2): U15.2 (ALERT/RDY)
Board_1-unconnected-(U16-ALERT/RDY-Pad2): U16.2 (ALERT/RDY)
Board_1-unconnected-(U17-ALERT/RDY-Pad2): U17.2 (ALERT/RDY)
Board_1-unconnected-(U18-ALERT/RDY-Pad2): U18.2 (ALERT/RDY)
Board_1-unconnected-(U19-NC-Pad7): U19.7 (NC)
Board_1-unconnected-(U19-NC-Pad8): U19.8 (NC)
Board_1-unconnected-(U19-R232-Pad15): U19.15 (R232)
Board_1-unconnected-(U19-~CTS-Pad9): U19.9 (~CTS)
Board_1-unconnected-(U19-~DCD-Pad12): U19.12 (~DCD)
Board_1-unconnected-(U19-~DSR-Pad10): U19.10 (~DSR)
Board_1-unconnected-(U19-~RI-Pad11): U19.11 (~RI)
Board_1-unconnected-(U20-~ALRT-Pad5): U20.5 (~ALRT)

Notes on the sheet:
Pin
V_USB - 6V MAX V_BATT - Single Cell (4.2V MAX)
Run
Espressif ESP32
Auto-Reset
USB-to-Serial Converter
IO15: Has builtin pullup at POR.
IO12
IO0
IO5
IO0: Avoid device connections. Can be used a stat LED.
IO2: Avoid external pullups - will cause bootloader fail.
600mA out 6V max in
Qwiic Connector
IO12 = MDTI, IO15 = MDTO
GPIO0/Boot Button
Lithium-Polymer Battery Charger
Status LED
Boot Mode Configuration
IO5: Has builtin pullup at POR.
Fuel Gauge
Use boot control pins with caution: 0, 2, 5, 12, 15
Analog
Single-cell LiPo battery
Charge current: I_CHG = 1000 / R_PROG R_PROG=2k : I_CHG=500mA
IO2
IO15
System Regulator
IO12: Avoid external pullups - will cause bootloader fail.
Motion Sensor
Reset Button
Default
If DTR is LOW, toggling RTS from HIGH to LOW resets to run mode. If RTS is HIGH, toggling DTR from LOW to HIGH resets to bootloader.
Bootloader
