Hasatio/esp32DevKitS/Rev1/panelization/panelization.kicad_pcb

## KiCad design Rev1/panelization/panelization.kicad_pcb (continued)

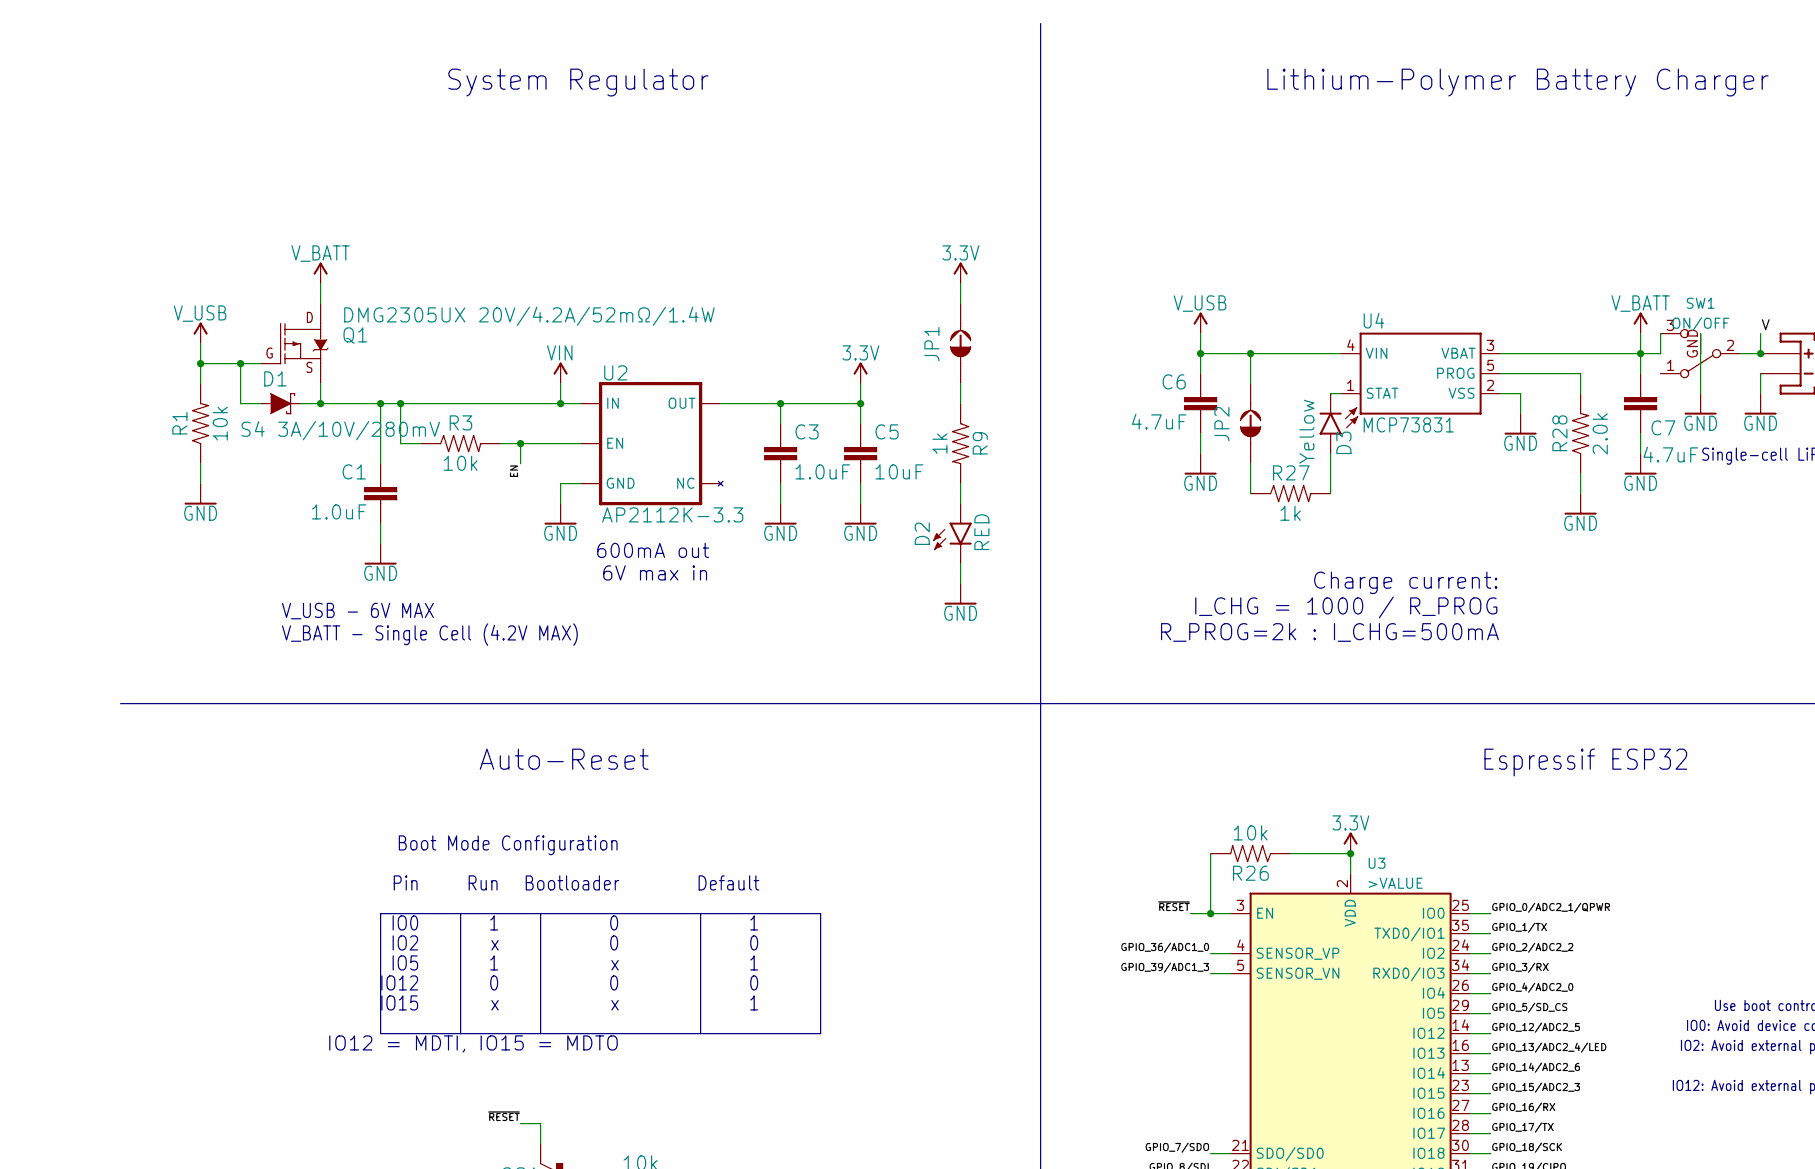
[picture p11: schematic R.kicad_sch, posture, part in row 1, column 1]

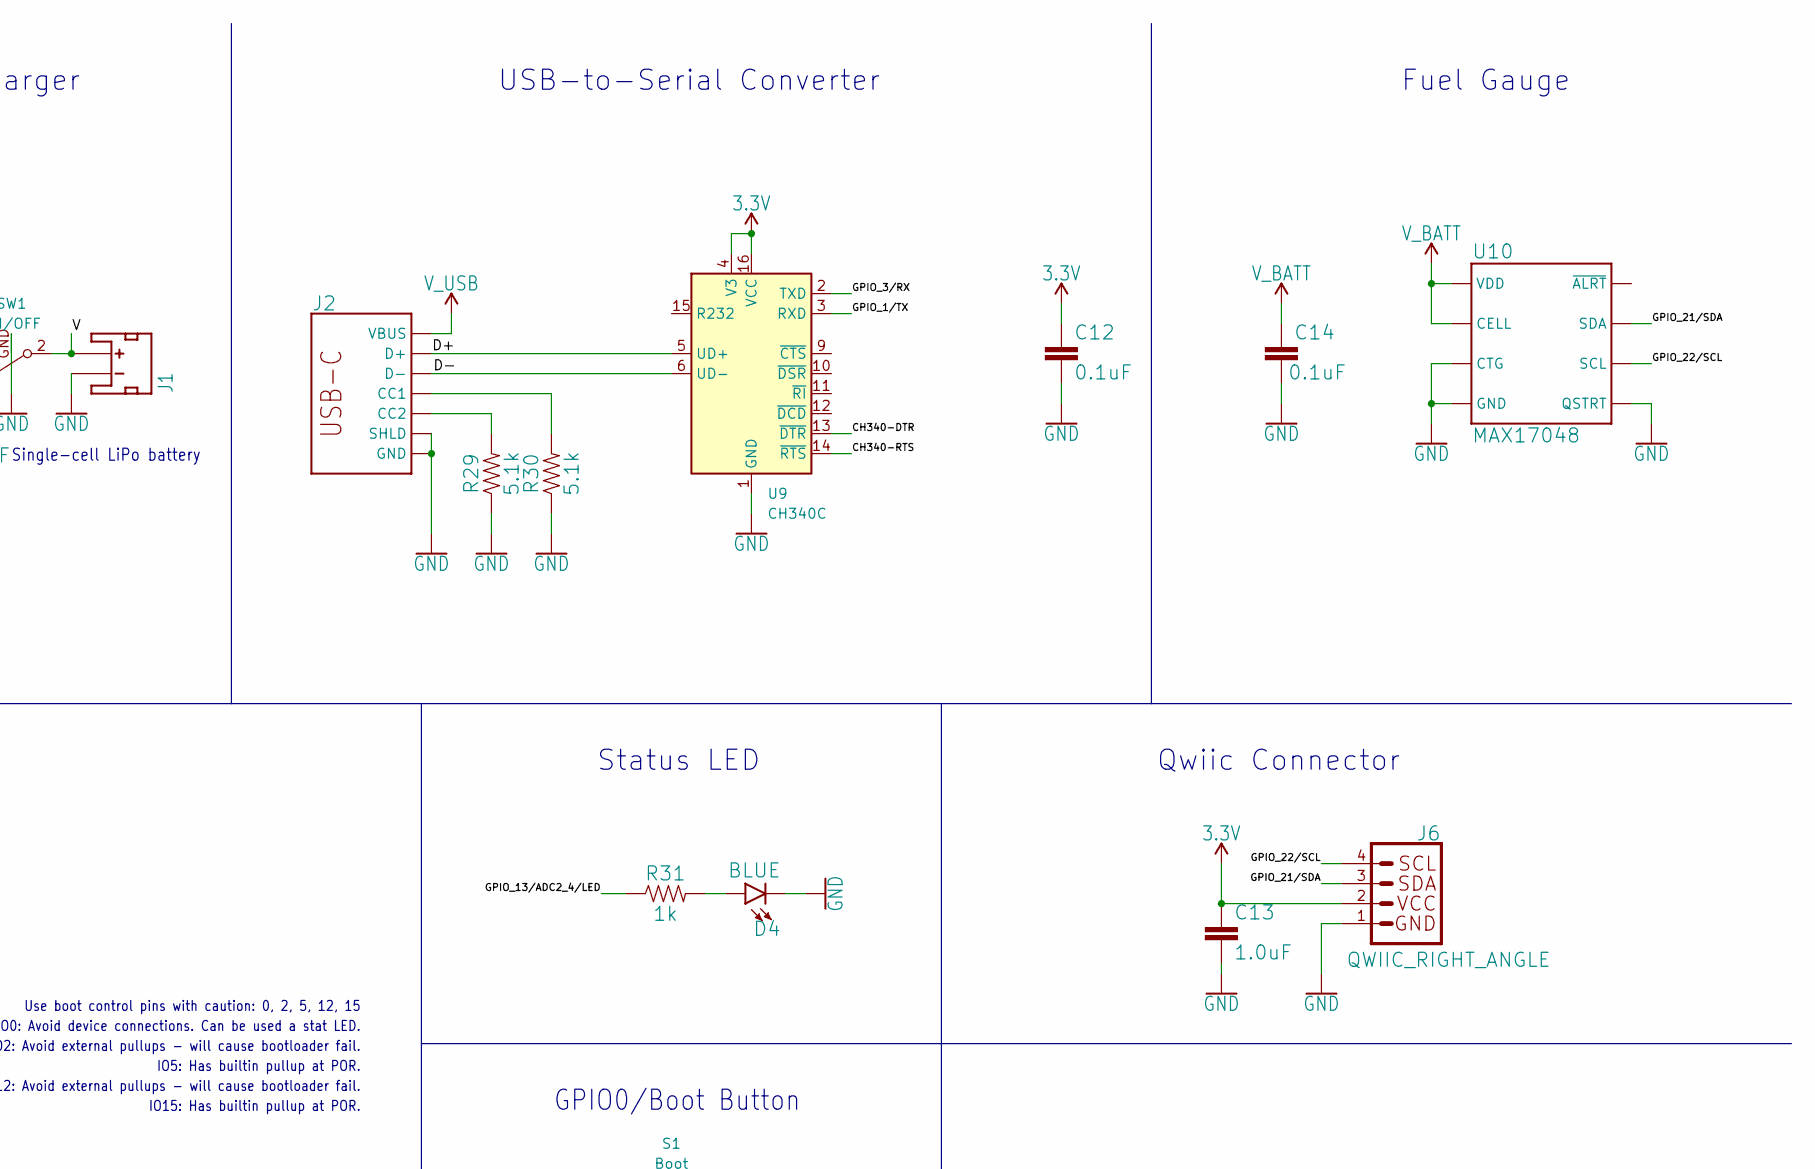
[picture p12: schematic R.kicad_sch, posture, part in row 1, column 2]

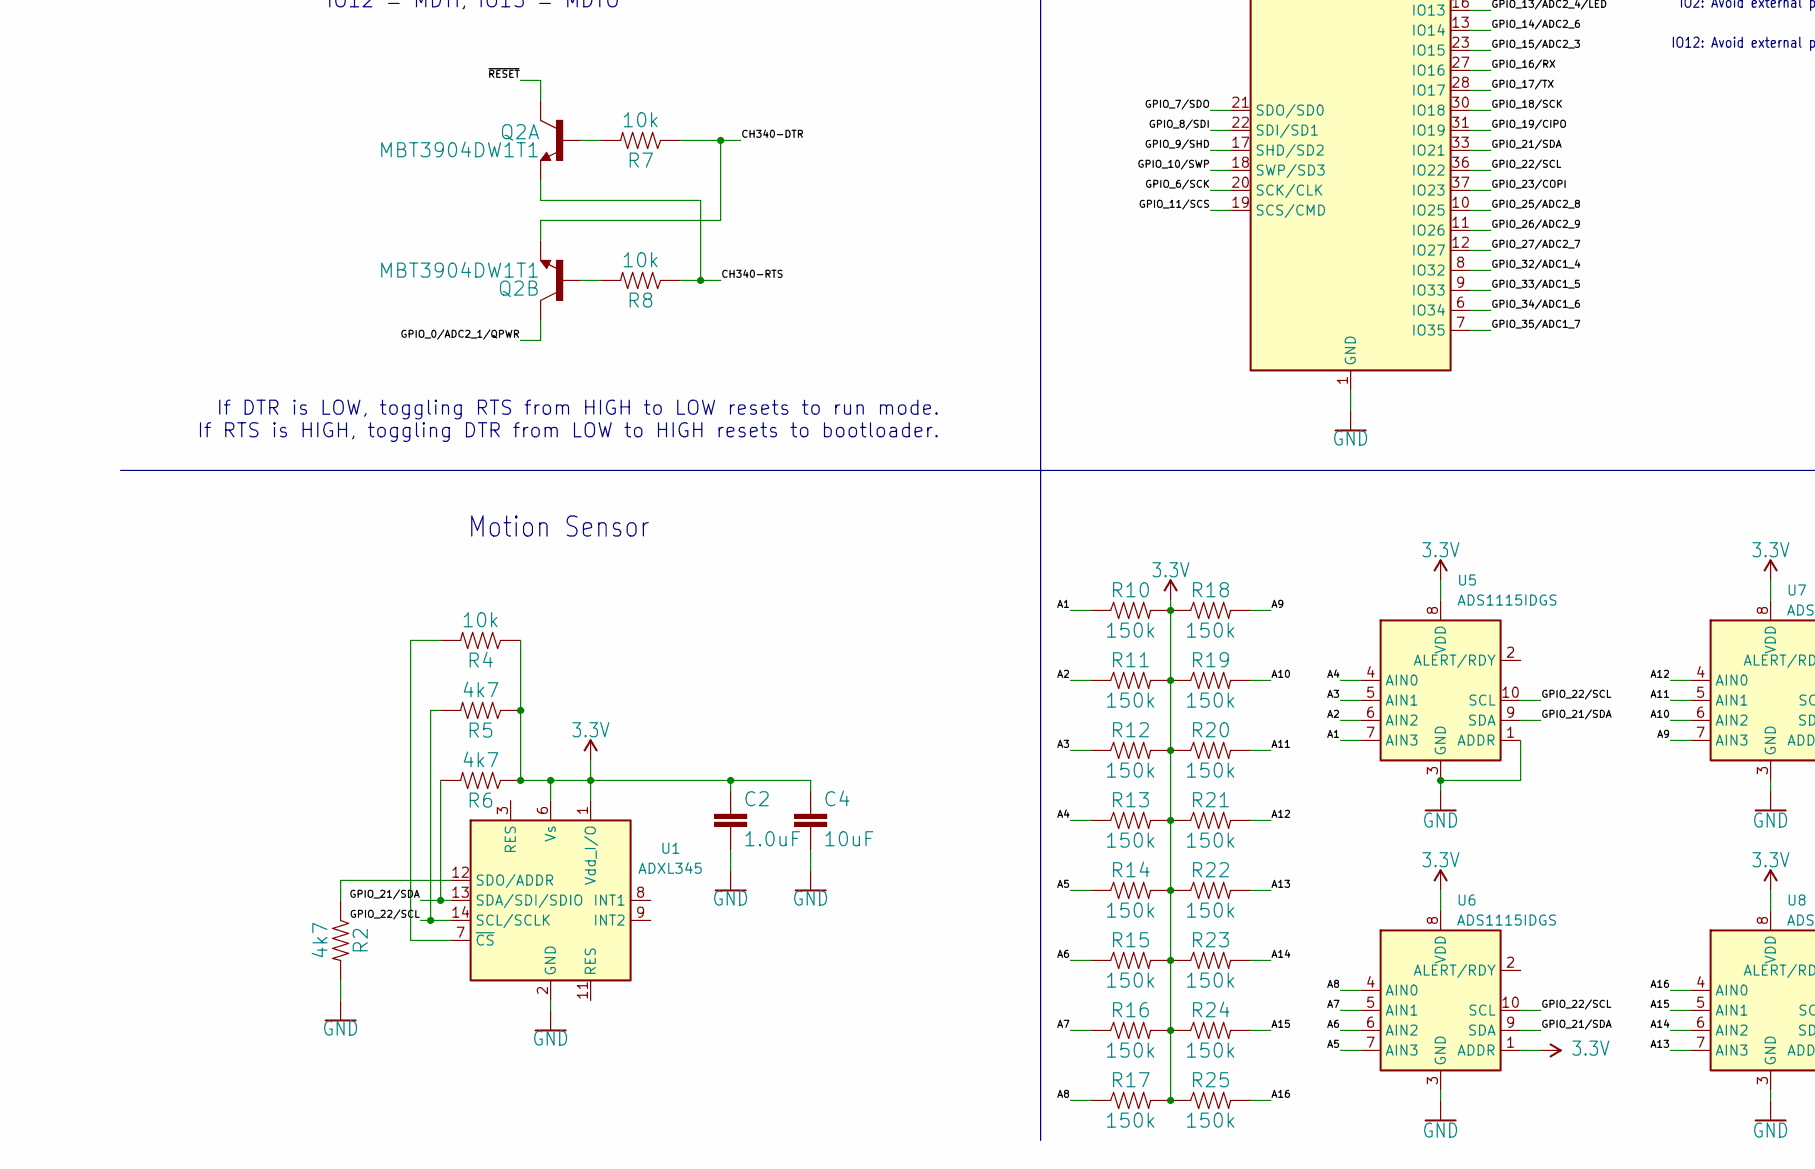
[picture p13: schematic R.kicad_sch, posture, part in row 2, column 1]

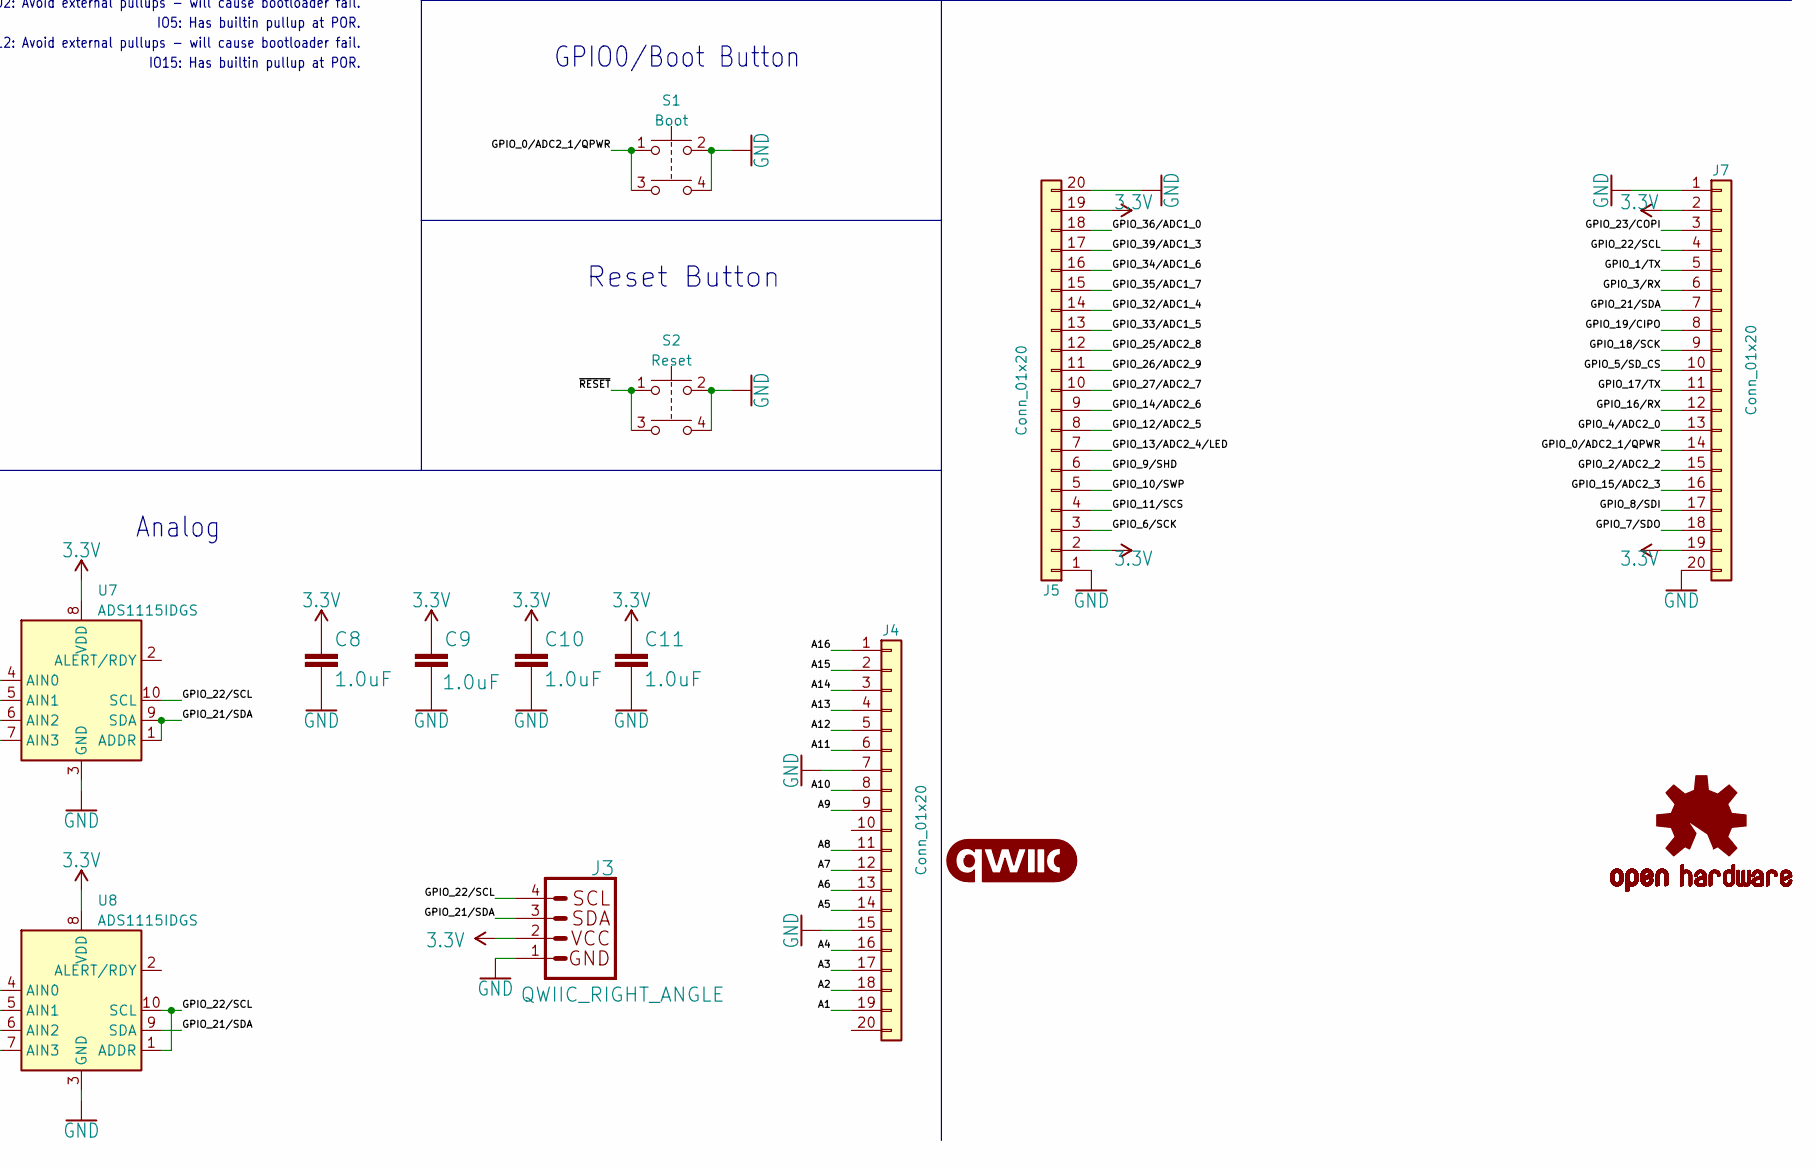
[picture p14: schematic R.kicad_sch, posture, part in row 2, column 2]

Parts:
C1, C2, C3, C8, C9, C10, C11, C13: 1.0uF; 0402-TIGHT
C4, C5: 10uF; 0402-TIGHT
C6, C7: 4.7uF; 0402-TIGHT
C12, C14: 0.1uF; 0402-TIGHT
D1: S4 3A/10V/280mV; SOD-323
D2: RED; LED-0603
D3: Yellow; LED-0603
D4: BLUE; LED-0603
J1: JST_2MM_MALE; JST-2-SMD
J2: USB_C_2-LAYER_PADS; USB-C-16P-2LAYER-PADS
J3, J6: QWIIC_RIGHT_ANGLE; JST04_1MM_RA
J4, J5, J7: Conn_01x20; Molex_200528-0200_1x20-1MP_P1.00mm_Horizontal
JP1, JP2: JUMPER-SMT_2_NC_TRACE_SILK; SMT-JUMPER_2_NC_TRACE_SILK
LOGO1: QWIIC_LOGO_4MM; QWIIC_4MM
LOGO2: OSHW-LOGOMINI; OSHW-LOGO-MINI
Q1: DMG2305UX 20V/4.2A/52mΩ/1.4W; SOT23-3
Q2: MBT3904DW1T1; SC70-6
R1, R3, R4, R7, R8, R26: 10k; 0402-TIGHT
R2, R5, R6: 4k7; 0402-TIGHT
R9, R27, R31: 1k; 0402-TIGHT
R10, R11, R12, R13, R14, R15, R16, R17, R18, R19, R20, R21, R22, R23, R24, R25: 150k; 0402-TIGHT
R28: 2.0k; 0402-TIGHT
R29, R30: 5.1k; 0402-TIGHT
S1: Boot; TACTILE_SWITCH_SMD_2.8X1.9MM
S2: Reset; TACTILE_SWITCH_SMD_2.8X1.9MM
SW1: ON/OFF; SW_SPDT_k3-1295
U1: ADXL345; LGA-14_3x5mm_P0.8mm_LayoutBorder1x6y
U2: SOT23-5
U3: >VALUE; ESP-WROOM-32-NARROW
U4: MCP73831; SOT23-5
U5, U6, U7, U8: ADS1115IDGS; TSSOP-10_3x3mm_P0.5mm
U9: CH340C; SOIC-16_3.9x9.9mm_P1.27mm
U10: MAX17048; DFN-8

Connections:
Board_0-3.3V: C2.1, C3.1, C4.1, C5.1, C8.1, C9.1, C10.1, C11.1, C12.1, C13.1, J3.2, J5.2, J5.19, J6.2, J7.2, J7.19, JP1.2, R4.1, R5.1, R6.1, R10.2, R11.2, R12.2, R13.2, R14.2, R15.2, R16.2, R17.2, R18.1, R19.1, R20.1, R21.1, R22.1, R23.1, R24.1, R25.1, R26.1, U1.1 (Vdd_I/O), U1.6 (Vs), U2.5 (OUT), U3.2 (VDD), U5.8 (VDD), U6.1 (ADDR), U6.8 (VDD), U7.8 (VDD), U8.8 (VDD), U9.4 (V3), U9.16 (VCC); also elsewhere on the board
Board_0-/A1: J4.19, R10.1, U5.7 (AIN3); also elsewhere on the board
Board_0-/A2: J4.18, R11.1, U5.6 (AIN2); also elsewhere on the board
Board_0-/A3: J4.17, R12.1, U5.5 (AIN1); also elsewhere on the board
Board_0-/A4: J4.16, R13.1, U5.4 (AIN0); also elsewhere on the board
Board_0-/A5: J4.14, R14.1, U6.7 (AIN3); also elsewhere on the board
Board_0-/A6: J4.13, R15.1, U6.6 (AIN2); also elsewhere on the board
Board_0-/A7: J4.12, R16.1, U6.5 (AIN1); also elsewhere on the board
Board_0-/A8: J4.11, R17.1, U6.4 (AIN0); also elsewhere on the board
Board_0-/A9: J4.9, R18.2, U7.7 (AIN3); also elsewhere on the board
Board_0-/A10: J4.8, R19.2, U7.6 (AIN2); also elsewhere on the board
Board_0-/A11: J4.6, R20.2, U7.5 (AIN1); also elsewhere on the board
Board_0-/A12: J4.5, R21.2, U7.4 (AIN0); also elsewhere on the board
Board_0-/A13: J4.4, R22.2, U8.7 (AIN3); also elsewhere on the board
Board_0-/A14: J4.3, R23.2, U8.6 (AIN2); also elsewhere on the board
Board_0-/A15: J4.2, R24.2, U8.5 (AIN1); also elsewhere on the board
Board_0-/A16: J4.1, R25.2, U8.4 (AIN0); also elsewhere on the board
Board_0-/CH340-DTR: Q2.1 (E), R7.1, U9.13 (~DTR)
Board_0-/CH340-RTS: Q2.4 (E), R8.1, U9.14 (~RTS)
Board_0-/D+: J2.A6 (D+), J2.B6 (D+), U9.5 (UD+)
Board_0-/D-: J2.A7 (D-), J2.B7 (D-), U9.6 (UD-)
Board_0-/EN: R3.2, U2.3 (EN)
Board_0-/GPIO_0/ADC2_1/QPWR: J7.14, Q2.6 (C), S1.1, S1.3, U3.25 (IO0)
Board_0-/GPIO_2/ADC2_2: J7.15, U3.24 (IO2)
Board_0-/GPIO_4/ADC2_0: J7.13, U3.26 (IO4)
Board_0-/GPIO_5/SD_CS: J7.10, U3.29 (IO5)
Board_0-/GPIO_6/SCK: J5.3, U3.20 (SCK/CLK)
Board_0-/GPIO_7/SDO: J7.18, U3.21 (SDO/SD0)
Board_0-/GPIO_8/SDI: J7.17, U3.22 (SDI/SD1)
Board_0-/GPIO_9/SHD: J5.6, U3.17 (SHD/SD2)
Board_0-/GPIO_10/SWP: J5.5, U3.18 (SWP/SD3)
Board_0-/GPIO_11/SCS: J5.4, U3.19 (SCS/CMD)
Board_0-/GPIO_12/ADC2_5: J5.8, U3.14 (IO12)
Board_0-/GPIO_13/ADC2_4/LED: J5.7, R31.1, U3.16 (IO13)
Board_0-/GPIO_14/ADC2_6: J5.9, U3.13 (IO14)
Board_0-/GPIO_15/ADC2_3: J7.16, U3.23 (IO15)
Board_0-/GPIO_16/RX: J7.12, U3.27 (IO16)
Board_0-/GPIO_17/TX: J7.11, U3.28 (IO17)
Board_0-/GPIO_18/SCK: J7.9, U3.30 (IO18)
Board_0-/GPIO_19/CIPO: J7.8, U3.31 (IO19)
Board_0-/GPIO_21/SDA: J3.3, J6.3, J7.7, R6.2, U1.13 (SDA/SDI/SDIO), U3.33 (IO21), U5.9 (SDA), U6.9 (SDA), U7.1 (ADDR), U7.9 (SDA), U8.9 (SDA), U10.8 (SDA); also elsewhere on the board
Board_0-/GPIO_22/SCL: J3.4, J6.4, J7.4, R5.2, U1.14 (SCL/SCLK), U3.36 (IO22), U5.10 (SCL), U6.10 (SCL), U7.10 (SCL), U8.1 (ADDR), U8.10 (SCL), U10.7 (SCL); also elsewhere on the board
Board_0-/GPIO_23/COPI: J7.3, U3.37 (IO23)
Board_0-/GPIO_25/ADC2_8: J5.12, U3.10 (IO25)
Board_0-/GPIO_26/ADC2_9: J5.11, U3.11 (IO26)
Board_0-/GPIO_27/ADC2_7: J5.10, U3.12 (IO27)
Board_0-/GPIO_32/ADC1_4: J5.14, U3.8 (IO32)
Board_0-/GPIO_33/ADC1_5: J5.13, U3.9 (IO33)
Board_0-/GPIO_34/ADC1_6: J5.16, U3.6 (IO34)
Board_0-/GPIO_35/ADC1_7: J5.15, U3.7 (IO35)
Board_0-/GPIO_36/ADC1_0: J5.18, U3.4 (SENSOR_VP)
Board_0-/GPIO_39/ADC1_3: J5.17, U3.5 (SENSOR_VN)
Board_0-/V: J1.2 (+), SW1.2 (B)
Board_0-/~RESET: Q2.3 (C), R26.2, S2.1, S2.3, U3.3 (EN)
Board_0-GND: C1.2, C2.2, C3.2, C4.2, C5.2, C6.2, C7.2, C8.2, C9.2, C10.2, C11.2, C12.2, C13.2, C14.2, D2.C, D4.C, J1.1 (-), J2.GND, J2.GND2 (GND), J2.SHLD1 (SHLD), J2.SHLD2 (SHLD), J2.SHLD3 (SHLD), J2.SHLD4 (SHLD), J3.1, J4.7, J4.15, J5.1, J5.20, J6.1, J7.1, J7.20, R1.1, R2.2, R28.1, R29.1, R30.1, S1.2, S1.4, S2.2, S2.4, SW1.GND, U1.2 (GND), U1.4 (GND), U1.5 (GND), U2.2 (GND), U3.1 (GND), U3.15 (GND), U3.38 (GND), U3.39 (GND), U4.2 (VSS), U5.1 (ADDR), U5.3 (GND), U6.3 (GND), U7.3 (GND), U8.3 (GND), U9.1 (GND), U10.1 (CTG), U10.4 (GND), U10.6 (QSTRT), U10.9 (GND); also elsewhere on the board
Board_0-Net-(D2-PadA): D2.A, R9.2
Board_0-Net-(D3-PadA): D3.A, R27.2
Board_0-Net-(D4-PadA): D4.A, R31.2
Board_0-Net-(J2-CC1): J2.A5 (CC1), R30.2
Board_0-Net-(J2-CC2): J2.B5 (CC2), R29.2
Board_0-Net-(JP1-Pad1): JP1.1, R9.1
Board_0-Net-(JP2-Pad1): JP2.1, R27.1
Board_0-Net-(Q2A-B): Q2.5 (B), R7.2
Board_0-Net-(Q2B-B): Q2.2 (B), R8.2
Board_0-Net-(U1-SDO/ADDR): R2.1, U1.12 (SDO/ADDR)
Board_0-Net-(U1-~CS): R4.2, U1.7 (~CS)
Board_0-Net-(U4-PROG): R28.2, U4.5 (PROG)
Board_0-Net-(U4-STAT): D3.C, U4.1 (STAT)
Board_0-VIN: C1.1, D1.C, Q1.2 (S), R3.1, U2.1 (IN)
Board_0-V_BATT: C7.1, C14.1, Q1.3 (D), SW1.3 (C), U4.3 (VBAT), U10.2 (CELL), U10.3 (VDD)
Board_0-V_USB: C6.1, D1.A, J2.VBUS1 (VBUS), J2.VBUS2 (VBUS), JP2.2, Q1.1 (G), R1.2, U4.4 (VIN)
Board_0-unconnected-(J1-PAD1-PadNC1): J1.NC1 (PAD1)
Board_0-unconnected-(J1-PAD2-PadNC2): J1.NC2 (PAD2)
Board_0-unconnected-(J4-Pin_10-Pad10): J4.10
Board_0-unconnected-(J4-Pin_20-Pad20): J4.20
Board_0-unconnected-(SW1-A-Pad1): SW1.1 (A)
Board_0-unconnected-(U1-INT1-Pad8): U1.8 (INT1)
Board_0-unconnected-(U1-INT2-Pad9): U1.9 (INT2)
Board_0-unconnected-(U1-NC-Pad10): U1.10 (NC)
Board_0-unconnected-(U1-RES-Pad3): U1.3 (RES)
Board_0-unconnected-(U1-RES-Pad11): U1.11 (RES)
Board_0-unconnected-(U2-NC-Pad4): U2.4 (NC)
Board_0-unconnected-(U3-NC-Pad32): U3.32 (NC)
Board_0-unconnected-(U5-ALERT/RDY-Pad2): U5.2 (ALERT/RDY)
Board_0-unconnected-(U6-ALERT/RDY-Pad2): U6.2 (ALERT/RDY)
Board_0-unconnected-(U7-ALERT/RDY-Pad2): U7.2 (ALERT/RDY)
Board_0-unconnected-(U8-ALERT/RDY-Pad2): U8.2 (ALERT/RDY)
Board_0-unconnected-(U9-NC-Pad7): U9.7 (NC)
Board_0-unconnected-(U9-NC-Pad8): U9.8 (NC)
Board_0-unconnected-(U9-R232-Pad15): U9.15 (R232)
Board_0-unconnected-(U9-~CTS-Pad9): U9.9 (~CTS)
Board_0-unconnected-(U9-~DCD-Pad12): U9.12 (~DCD)
Board_0-unconnected-(U9-~DSR-Pad10): U9.10 (~DSR)
Board_0-unconnected-(U9-~RI-Pad11): U9.11 (~RI)
Board_0-unconnected-(U10-~ALRT-Pad5): U10.5 (~ALRT)

Notes on the sheet:
GPIO0/Boot Button
If DTR is LOW, toggling RTS from HIGH to LOW resets to run mode. If RTS is HIGH, toggling DTR from LOW to HIGH resets to bootloader.
Lithium-Polymer Battery Charger
Single-cell LiPo battery
IO5: Has builtin pullup at POR.
Charge current: I_CHG = 1000 / R_PROG R_PROG=2k : I_CHG=500mA
Reset Button
IO12 = MDTI, IO15 = MDTO
Boot Mode Configuration
Pin
Default
Run
600mA out 6V max in
USB-to-Serial Converter
IO12: Avoid external pullups - will cause bootloader fail.
Fuel Gauge
Bootloader
System Regulator
IO5
IO15: Has builtin pullup at POR.
IO15
Qwiic Connector
Auto-Reset
Use boot control pins with caution: 0, 2, 5, 12, 15
IO0
IO0: Avoid device connections. Can be used a stat LED.
IO12
Espressif ESP32
IO2: Avoid external pullups - will cause bootloader fail.
Analog
IO2
Status LED
Motion Sensor
V_USB - 6V MAX V_BATT - Single Cell (4.2V MAX)

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
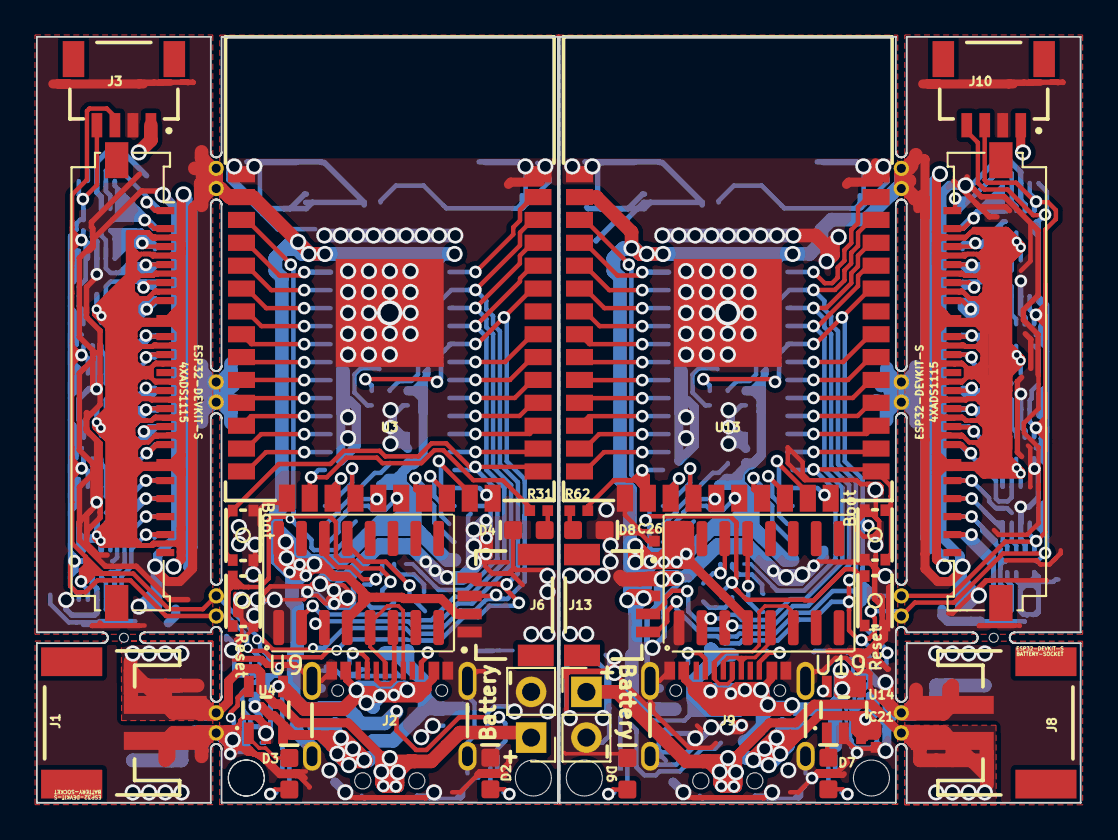
[picture p15: board panelization.kicad_pcb from above]

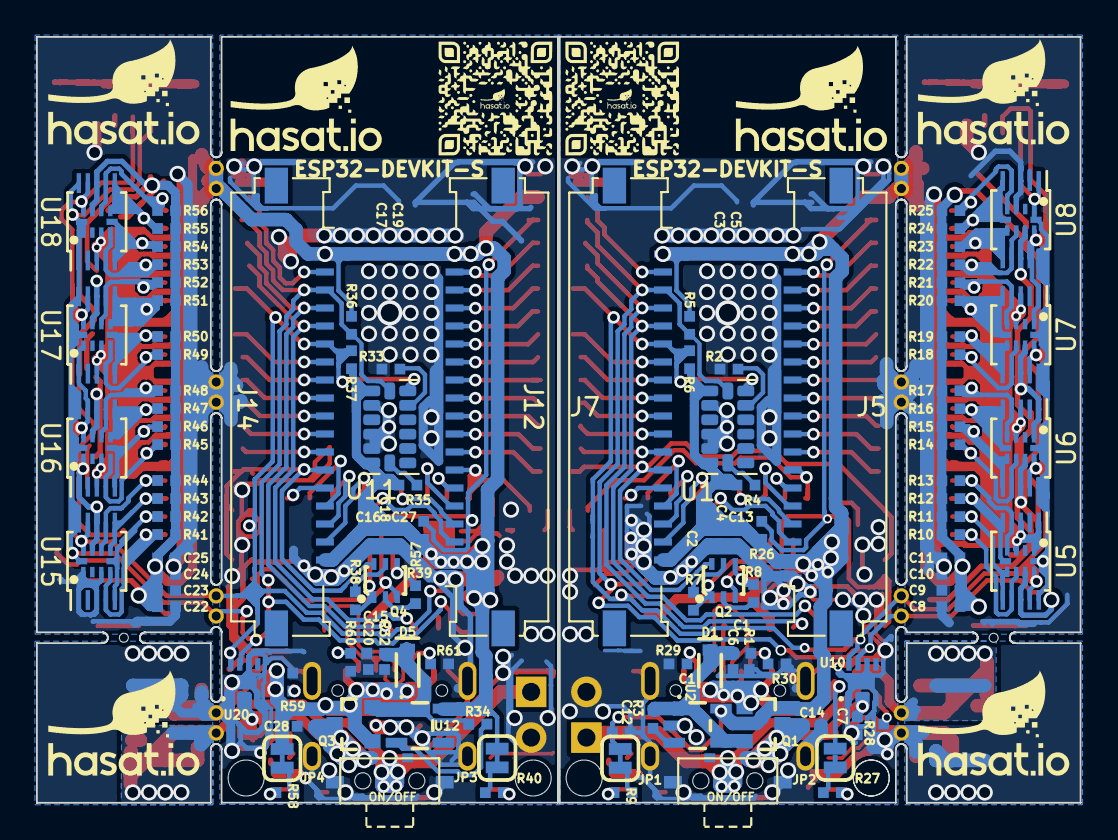
[picture p16: board panelization.kicad_pcb from below]

Board: 2 copper layers, 58.0 x 42.5 mm, 164 parts (124 on the bottom side), 146 nets.

Other parts of the board:
>NAME: >VALUE; QFN-10-RSE
>NAME#2, >NAME#3, >NAME#4, >NAME#5, >NAME#6, >NAME#7, >NAME#8: >VALUE; QFN-10-RSE
mouse-bite-1mm-slot, mouse-bite-1mm-slot#2: VAL**; mouse-bite-1mm x2
mouse-bite-emm-slot: VAL**; mouse-bite-1mm 2
mouse-bite-emm-slot#2, mouse-bite-emm-slot#3, mouse-bite-emm-slot#4, mouse-bite-emm-slot#5, mouse-bite-emm-slot#6, mouse-bite-emm-slot#7, mouse-bite-emm-slot#8: VAL**; mouse-bite-1mm 2

Their connections:
Board_0-3.3V: >NAME.8, >NAME#3.8, >NAME#7.1, >NAME#7.8, >NAME#8.8; also elsewhere on the board
Board_0-/A1: >NAME#8.7; also elsewhere on the board
Board_0-/A2: >NAME#8.6; also elsewhere on the board
Board_0-/A3: >NAME#8.5; also elsewhere on the board
Board_0-/A4: >NAME#8.4; also elsewhere on the board
Board_0-/A5: >NAME#7.7; also elsewhere on the board
Board_0-/A6: >NAME#7.6; also elsewhere on the board
Board_0-/A7: >NAME#7.5; also elsewhere on the board
Board_0-/A8: >NAME#7.4; also elsewhere on the board
Board_0-/A9: >NAME.7; also elsewhere on the board
Board_0-/A10: >NAME.6; also elsewhere on the board
Board_0-/A11: >NAME.5; also elsewhere on the board
Board_0-/A12: >NAME.4; also elsewhere on the board
Board_0-/A13: >NAME#3.7; also elsewhere on the board
Board_0-/A14: >NAME#3.6; also elsewhere on the board
Board_0-/A15: >NAME#3.5; also elsewhere on the board
Board_0-/A16: >NAME#3.4; also elsewhere on the board
Board_0-/GPIO_21/SDA: >NAME.1, >NAME.9, >NAME#3.9, >NAME#7.9, >NAME#8.9; also elsewhere on the board
Board_0-/GPIO_22/SCL: >NAME.10, >NAME#3.1, >NAME#3.10, >NAME#7.10, >NAME#8.10; also elsewhere on the board
Board_0-GND: >NAME.3, >NAME#3.3, >NAME#7.3, >NAME#8.1, >NAME#8.3; also elsewhere on the board
Board_1-3.3V: >NAME#2.8, >NAME#4.1, >NAME#4.8, >NAME#5.8, >NAME#6.8; also elsewhere on the board
Board_1-/A1: >NAME#6.4; also elsewhere on the board
Board_1-/A2: >NAME#6.5; also elsewhere on the board
Board_1-/A3: >NAME#6.6; also elsewhere on the board
Board_1-/A4: >NAME#6.7; also elsewhere on the board
Board_1-/A5: >NAME#4.4; also elsewhere on the board
Board_1-/A6: >NAME#4.5; also elsewhere on the board
Board_1-/A7: >NAME#4.6; also elsewhere on the board
Board_1-/A8: >NAME#4.7; also elsewhere on the board
Board_1-/A9: >NAME#5.4; also elsewhere on the board
Board_1-/A10: >NAME#5.5; also elsewhere on the board
Board_1-/A11: >NAME#5.6; also elsewhere on the board
Board_1-/A12: >NAME#5.7; also elsewhere on the board
Board_1-/A13: >NAME#2.4; also elsewhere on the board
Board_1-/A14: >NAME#2.5; also elsewhere on the board
Board_1-/A15: >NAME#2.6; also elsewhere on the board
Board_1-/A16: >NAME#2.7; also elsewhere on the board
Board_1-/GPIO_21/SDA: >NAME#2.9, >NAME#4.9, >NAME#5.1, >NAME#5.9, >NAME#6.9; also elsewhere on the board
Board_1-/GPIO_22/SCL: >NAME#2.1, >NAME#2.10, >NAME#4.10, >NAME#5.10, >NAME#6.10; also elsewhere on the board
Board_1-GND: >NAME#2.3, >NAME#4.3, >NAME#5.3, >NAME#6.1, >NAME#6.3; also elsewhere on the board
